Club-INTech/Balise-Ultrasons-TechTheTroll/README

Ceci est le dépôt de la balise de l'équipe TechTheTroll, conçue par Sylvain
