Club-INTech/Balise-Ultrasons-TechTheTroll/python/papier_presentation.tex

\documentclass[a4paper, 8pt]{article}

\usepackage{tikz}
\usepackage[T1]{fontenc}     
\usepackage[french]{babel}
\usepackage[utf8]{inputenc}   
\usepackage{amsmath}
\usepackage{amsmath}
\usepackage{enumitem}
\usepackage{hyperref}
\usepackage[]{algorithm2e}
\usepackage{geometry}
\geometry{hmargin=1cm,vmargin=1cm}

\title{Repérage grâce à un système de balise à ultrason et filtrage}
\author{Clément Besnier}
%\setlength{\textwidth}{500pt}
%\date{}
\begin{document}

\maketitle
\tableofcontents
\section{Introduction}

Chaque année a lieu la coupe de France de robotique. Durant cette compétition, deux robots évoluent sur une table de deux mètres sur trois en 90 secondes pour obtenir un maximum de points. La table étant partagée en même temps par deux robots, il est nécessaire d'éviter le robot adverse pour des raisons de sécurité et pour des raisons stratégiques. C'est la raison même d'un tel système de balisage.

\centerline{\input{schema_table.tex}}

\section{Système de balisage}

Le système de balisage est composé d'une partie émettrice et d'une partie réceptrice. La partie émettrice (PE) est placée sur le robot adverse et émet des ultrasons. La partie réceptrice (PR) est composée de trois balises qui se trouvent autour de la table (Voir figure 1). Les trois balises sont synchronisées entre elles mais ne le sont pas avec la partie émettrice. 

\section{Repérage}

PE émet à intervalle régulier un signal particulier. Soient $ t_{1}, t_{2}, t_{3}$  respectivement les dates de réception du même signal par PR. Comme PE et PR ne sont pas synchronisées il est impossible de calculer la durée entre l'émission du signal et sa réception et donc on ne peut pas trianguler le signal pour en retrouver l'origine. Cependant, on est certain des trois valeurs suivantes : 

\begin{equation}\label{1}
		\begin{split}
		& t_{1} - t_{2}\\
		& t_{1} - t_{3}\\
		& t_{2} - t_{3}
		\end{split}
\end{equation}

, ce qui est proportionnel à
\begin{equation}\label{2}
		\begin{split}
		& m_{1} = d((x,y),PR1)-d((x,y),PR2)\\
		& m_{2} = d((x,y),PR1)-d((x,y),PR3)\\
		& m_{3} = d((x,y),PR2)-d((x,y),PR3)
		\end{split}
\end{equation}

, il faut juste multiplier les différences de dates par la vitesse du son dans l'air dans des conditions normales. Les mesures $m_{1}, m_{2},  m_{3}$ permettent de retrouver (x,y) en résolvant le système. Vous pouvez trouver en annexe les équations (pas belles). Mais ce n'est pas comme ça qu'on va en réalité trouver ce qu'on veut.

\section{Modélisation et Simulation}

%Avant de pouvoir faire des mesures sur le robot, on simule les mesures en ajoutant un bruit gaussien aux $ m_{1}, m_{2},  m_{3}$.
Soit $X_t$, la position du robot à l'instant t.
\begin{equation}
	\begin{split}\label{3}
		X_t  &= \begin{pmatrix}
			x_t  \\
			y_t 
		\end{pmatrix}\\
	\end{split}
\end{equation}

Soit $Y_t$ la mesure prise à l'instant t.
\begin{equation} \label{4}
	\begin{split}
	Y_t &= \begin{pmatrix}
			m_1  \\
			m_2  \\
			m_3
		\end{pmatrix}\\
	\end{split}
\end{equation}

Soit H la fonction qui à une position (x, y) associe la différence de distance entre cette position etles balises suivant le schéma suivant : 
\begin{equation}
	\begin{split}\label{5}
		H(x, y)  &= 
		\begin{pmatrix}
				d((x,y),PR1) - d((x,y),PR2)\\
				d((x,y),PR1) - d((x,y),PR3)\\
				d((x,y),PR2) - d((x,y),PR3)
		\end{pmatrix}\\
	\end{split}
\end{equation}

On considère les $Y_t$ ainsi parce que c'est plus clair de raisonner avec des distances qu'avec des différences de temps. On notera les valeurs estimées avec un accent circonflexe sur la lettre, les valeurs simulées avec un tilde.
Soit E([$t_1$, $t_2$], PAS) une liste dont les éléments dont les multiples de $t_1$ compris entre $t_1$ et $t_2$. On considèrera dans la suite que l'unité de ses éléments est en seconde. 
[$t_1$, $t_2$] sera [0, 90] parce qu'un match dure 90 s. Le pas n'est pas encore décidé, cela dépendra des ressources disponibles du robot. On prendra pour l'exemple PAS = 0.025 s.

Pour le filtrage, on considérera ces équations avec Q, matrice de covariance de l'équation d'évolution et R, matrice de covariance de l'équation d'observation

L'équation d'observation est : 
\begin{equation}
	X_t = H(Y_t) + \mathcal{N}(0, R)
\end{equation}

L'équation d'évolution est : 
\begin{equation}
	X_{t+1} = G(X_{t}) + \mathcal{N}(0, Q)
\end{equation}

\begin{algorithm}[H]
		
		\Donnees{$C = [(x_t, y_t), t \in E([0, 90], 0.025)]$ le chemin, $\sigma^2$ la variance }
		\Res{$MB = [(m_1(t), m_2(t), m_3(t)]$}
		\ForAll{($x_t$, $y_t$) $\in$ C}
		{$m_1$, $m_2$, $m_3$ = h($x_t$, $y_t$) \\
		$\tilde{m_1}$, $\tilde{m_2}$, $\tilde{m_3}$ = {$m_1$} + $\mathcal{N}$(0, $\sigma^2$), {$m_2$} + $\mathcal{N}$(0, $\sigma^2$), {$m_3$} + $\mathcal{N}$(0, $\sigma^2$)\\
		Ajouter ($\tilde{m_1}$, $\tilde{m_2}$, $\tilde{m_3}$) à MB
		}
		
	\caption{Simulation du bruitage de mesures.}
	\end{algorithm}

\section{Filtrage}

On utilise ici un filtre de Kalman unscented.

%Algorithme de Kalman
%\begin{algorithm}[H]
%		
%		\KwData{$tag(w_{i}) = t_{i}$ et $tag(w_{i+1}) = t_{i+1} C(t_{i},t_{i+1}) = \{(w_i,w_{i+1})| T(w_i) = t_i~et~T(w_{i+1}) = t_{i+1} \}, w_{1:N}$}
%		\KwResult{$q_{i}(w_{i},w_{i+1}) i \in \{1 .. N-1\}$}
%		\eIf{$(w_{i},w_{i+1}) \in C(t_{i},t_{i+1}) $}{$q_{i}(w_{i},w_{i+1}) = p(t_{i},t_{i+1},w_{i},w_{i+1})$}{
%		\eIf{$w_{i} \in C(t_{i},t_{i+1})$ et $w_{i+1} \in C(t_{i},t_{i+1})$}{$q_{i}(w_{i},w_{i+1}) = p(t_{i},t_{i+1},w_{i}) * p(t_{i},t_{i+1},w_{i+1})$}{
%		\eIf{$w_{i} \in C(t_{i},t_{i+1})$}{$q_{i}(w_{i},w_{i+1}) = p(t_{i},t_{i+1},w_{i})$}{
%		\eIf{$w_{i+1} \in C(t_{i},t_{i+1})$}{$q_{i}(w_{i},w_{i+1}) = p(t_{i},t_{i+1},w_{i+1})$}{$q_{i}(w_{i},w_{i+1}) = p(t_{i},t_{i+1})$}}}}
%	\caption{Détermination de $q_i$ pour $i \in \{1..N-1\}$}
%	\end{algorithm}
%	

\begin{algorithm}[H]
\Donnees{d = 2 : dimension des mesures, $\alpha$ = 1, $\beta$ = 0, $\kappa$ = 2, $\mu_0$  : position initiale, $\Sigma_0$ matrice de covariance initiale, 

$\lambda$ = $\alpha^2*(d+\kappa)$ - d, $\gamma = d+\lambda$, 

Q : matrice de covariance de l'équation d'évolution, R : matrice de covariance de l'équation d'observation, 

H est décrite telle que dans la partie 4 et G est la fonction identité.

$w^{0}_m = \frac{\lambda}{d+\lambda}$, $w^{0}_c = w^{0}_m+(1-\alpha^2+\beta)$, $w^i_c = w^{i}_{m} = \frac{1}{2*(d+\lambda)}$}
%\KwResult{$q_{i}(w_{i},w_{i+1}) i \in \{1 .. N-1\}$}
\Repeter{plus aucune mesure}
{
	Partie prédiction :
	
	\Deb{$\sqrt{\Sigma}$ = decompositionDeCholesky($\gamma*\Sigma$);
		
	$\dot{\sigma}_{t-1}$ = [$\mu_{t-1}$; $\mu_{t-1} - \sqrt{\Sigma}_{:,i}~(i \in \{1, ..., d\}); \mu_{t-1} + \sqrt{\Sigma}_{:,i}~(i \in \{1,..., d\})$];
	
	\Pour{$i \in \{0,..., 2*d\}$}
	{
	$\bar{z}^{*~i}_t = G(\dot{\sigma}^{i}_{t-1})$;
	}
	$\bar{\mu}_{t} = \sum_{i = 0}^{2*d}w^i_m*\bar{z}^{*i}_t$;
	
	$\bar{\Sigma}_t = \sum_{i=0}^{2*d} w^i_c(\bar{z}^{*i}_t - \bar{\mu}_t)(\bar{z}^{*i}_t - \bar{\mu}_t)^{T} + Q_t$;}
	
	Partie mise-à-jour grâce à l'observation :
	
	\Deb{
	$\sqrt{\bar{\Sigma}}$ =decompositionDeCholesky($\gamma*\bar{\Sigma}$);
	
	$\bar{\dot{\sigma}}_{t}$ = [$\mu$; $\mu - \sqrt{\bar{\Sigma}_{:,i}}~(i \in \{1, ..., d\}); \mu + \sqrt{\bar{\Sigma}_{:,i}}~(i \in \{1,..., d\})$];
	
	\Pour{$i \in \{0,..., 2*d\}$}
	{
	$\bar{y}^{*~i}_t = H(\bar{\dot{\sigma}}^i_{t})$;
	}
	
	$\hat{y}^{*i}_t = \sum_{i = 0}^{2*d} w^{i}_{m}*\bar{y}^{*i}_{t}$;
	
	$S_t = \sum_{i=0}^{2*d} w_{c}^{i}(\bar{y}^{*i}_t - \hat{y}^{*i}_t)*(\bar{y}^{*i}_t - \hat{y}^{*i}_t)^{T} + R_t$;}
	
	Partie estimation de l'état actuel :
	
	\Deb{
	$\bar{\Sigma}^{z,y}_t = \sum_{i=0}^{2*d} w^{i}_{c} (\bar{z}^{*i}_t - \bar{\mu}_t)*(\bar{y}^{*i}_t - \hat{y}^{*i}_t)^{T}$;
	
	$K_t = \bar{\Sigma}^{z,y}_t*S_t^{-1}$;
	
	$\mu_t = \bar{\mu}+K_t*(y_t - \hat{y}_{t}) $;
	
	$\Sigma_t = \bar{\Sigma} - K_t*S_t*K^T_t$;
		
	}
		
}
		
	\caption{Algorithme de Kalman Unscented}
	\end{algorithm}

\section{De la mesure venant des balises à la mesure qui rejoint le modèle}

Sylvain donne les mesures et obtient trois valeurs pour une salve de mesures qu'on va appeler $t_1, t_2, t_3$. J'ai vu que nous avions tous les 3 un positionnement des balises différent. J'ai donc fait des échanges comme il convient.
Position (-1500, 0). Sylvain : 1. Clément : 1. Ivan : 2.
Position (-1500, 2000). Sylvain : 2. Clément : 3. Ivan : 3.
Position (1500, 1000). Sylvain : 3. Clément : 2. Ivan : 1.
Donc il faut faire les échanges de valeurs en conséquence. Les valeurs sont en microsecondes donc il faut les convertir en secondes en divisant par $10^6$. Il faut convertir ce temps en distance (qui pour l'instant ne veut rien dire) en multipliant par la vitesse du son en millimètre par seconde. On obient alors des distances que l'on appelle $d_1, d_2, d_3$. Il suffit de faire les différences de distance comme il suit : $m_1 = d_1 - d_2, m_2 = d_1 - d_3, m_3 = d_2 - d_3$.

Pour résumer, Ivan, tu dois faire : $m_1 = (t_3 - t_1)*v_s/10^6, m_2 = (t_3 - t_2)*v_s/10^6, m_3 = (t_1 - t_2)*v_s/10^6$.

Pour résumer, et moi je dois faire : $m_1 = (t_1 - t_3)*v_s/10^6, m_2 = (t_1 - t_2)*v_s/10^6, m_3 = (t_3 - t_2)*v_s/10^6$.

\section{Annece I : Notations}
Soit M une matrice de taille (m, n). On note $M_{:,i}$ le vecteur colonne correspondant à la colonne i ($i \in \{1,...,n\}$) de M.

\section{Annexe II : mesure vers état}

Les trois équations du système représentent trois équations d'hyperbole. (x,y) se retrouvent à l'intersection de trois branches d'hyperbole. Cependant,la formule donnée à Mathematica (CHANGER LA FORMULATION) donne, pour chaque couple possible d'équation, deux solutions. Au total il y a 6 solutions.

\begin{itemize}[label=$\bullet$]
		
\item équation 1 1 2
{\tiny
\begin{equation} \label{3}
	\begin{split}
	a & = \sqrt{-(-10+{{m}_{1}}^{2})*{({m}_{1}+{m}_{2})}^{2}*(-10+{{m}_{2}}^{2})*(-4+{{m}_{1}}^{2}-2*{{m}_{1}}^{2}+{{m}_{2}}^{2})}\\
	x & = \frac{-(-12+6*{{m}_{1}}^{2}-12*{m}_{1}*{m}_{2}+3*{{m}_{1}}^{3}*{m}_{2}+6*{{m}_{2}}^{2}-6*{{m}_{1}}^{2}*{{m}_{2}}^{2}+3*{m}_{1}*{{m}_{2}}^{3}+a)}{4*(-18+5*{{m}_{1}}^{2}-8*{m}_{1}*{m}_{2}+5*{{m}_{2}}^{2})} \\
	Q & = 4*({m}_{1}+{m}_{2})*(-18+5*{{m}_{1}}^{2}-8*{m}_{1}*{m}_{2}+5*{{m}_{2}}^{2})\\
	y & =  \frac{-1}{Q*(72*{m}_{1}-28*{{m}_{1}}^{3}+72*{m}_{2}+4*{{m}_{1}}^{2}*{m}_{2}+{{m}_{1}}^{4}*{m}_{2}+20*{m}_{1}*{{m}_{2}}^{2}+{{m}_{1}}^{3}*{{m}_{2}}^{2}-12*{{m}_{2}}^{3}-{{m}_{1}}^{2}*{{m}_{2}}^{3}-{m}_{1}*{{m}_{2}}^{4}-3*{m}_{1}*a+3*{m}_{2}*a)} 
	\end{split}
	\end{equation}
}
\item équation 2 1 2
{\tiny
   \begin{equation} \label{4}
   	\begin{split}
    a & = \sqrt{-(-10+{{m}_{1}}^{2})*{({m}_{1}+{m}_{2})}^{2}*(-10+{{m}_{2}}^{2})*(-4+{{m}_{1}}^{2}-2*{m}_{1}*{m}_{2}+{{m}_{2}}^{2})}\\
   	x & = \frac{-(-12+6*{{m}_{1}}^{2}-12*{m}_{1}*{m}_{2}+3*{{m}_{1}}^{3}*{m}_{2}+6*{{m}_{2}}^{2}-6*{{m}_{1}}^{2}*{{m}_{2}}^{2}+3*{m}_{1}*{{m}_{2}}^{3}-a)}{4*(-18+5*{{m}_{1}}^{2}-8*{m}_{1}*{m}_{2}+5*{{m}_{2}}^{2})} \\
   	Q & = 4*({m}_{1}+{m}_{2})*(-18+5* {{m}_{1}}^{2}-8*{m}_{1}*{m}_{2}+5*{{m}_{2}}^{2})\\
   	 y &  = \frac{-1}{Q*(72*{m}_{1}-28*{{m}_{1}}^{3}+72*{m}_{2}+4*{{m}_{1}}^{2}*{m}_{2}+{{m}_{1}}^{4}*{m}_{2}+20*{m}_{1}*{{m}_{2}}^{2}+{{m}_{1}}^{3}*{{m}_{2}}^{2}-12*{{m}_{2}}^{3}-{{m}_{1}}^{2}* {{m}_{2}}^{3}-{m}_{1}*{{m}_{2}}^{4}+3*{m}_{1}*a-3*{m}_{2}*a)} 
   	\end{split}
   	\end{equation}
}
\item équation 1 2 3
{\tiny
 \begin{equation} \label{5}
   	\begin{split}
   a & = \sqrt{-(-10+{{m}_{2}}^{2})*{(-2*{m}_{2}+{m}_{3})}^{2}*(-4+{{m}_{3}}^{2})*(-10+{{m}_{2}}^{2}-2*{m}_{2}*{m}_{3}+{{m}_{3}}^{2})}\\
   x  & =  \frac{-(-12+6*{{m}_{3}}^{2}+3*{{m}_{2}}^{2}*{{m}_{3}}^{2}-3*{m}_{2}*{{m}_{3}}^{3}-a)}{4*(-18+2*{{m}_{2}}^{2}-2*{m}_{2}*{m}_{3}+5*{{m}_{3}}^{2})} \\
   	 y &  = \frac{-144*{m}_{2}+16*{{m}_{2}}^{3}+72*{m}_{3}-56*{{m}_{2}}^{2}*{m}_{3}+4*{{m}_{2}}^{4}*{m}_{3}+80*{m}_{2}*{{m}_{3}}^{2}-8*{{m}_{2}}^{3}*{{m}_{3}}^{2}-28*{{m}_{3}}^{3}+5*{{m}_{2}}^{2}*{{m}_{3}}^{3}-{m}_{2}*{{m}_{3}}^{4}+3*{m}_{3}*a}{4*(2*{m}_{2}-{m}_{3})*(-18+2*{{m}_{2}}^{2}-2*{m}_{2}*{m}_{3}+5*{{m}_{3}}^{2})}
   	\end{split}
 \end{equation}
}
\item équation 2 2 3
{\tiny
\begin{equation} \label{6}
   	\begin{split}
   [a & = \sqrt-(-10+{{m}_{2}}^{2})*{(-2*{m}_{2}+{m}_{3})}^{2}*(-4+{{m}_{3}}^{2})*(-10+{{m}_{2}}^{2}-2*{m}_{2}*{m}_{3}+{{m}_{3}}^{2})\\
  x & = \frac{-(-12+6*{{m}_{3}}^{2}+3*{{m}_{2}}^{2}*{{m}_{3}}^{2}-3*{m}_{2}*{{m}_{3}}^{3}+a)}{4*(-18+2*{{m}_{2}}^{2} -2*{m}_{2}*{m}_{3}+5*{{m}_{3}}^{2})} \\
   	 y & = \frac{-144*{m}_{2}+16*{{m}_{2}}^{3}+72*{m}_{3}-56*{{m}_{2}}^{2}*{m}_{3}+4*{{m}_{2}}^{4}*{m}_{3}+80*{m}_{2}*{{m}_{3}}^{2}-8*{{m}_{2}}^{3}*{{m}_{3}}^{2}-28*{{m}_{3}}^{3}+5*{{m}_{2}}^{2}*{{m}_{3}}^{3}-{m}_{2}*{{m}_{3}}^{4}-3*{m}_{3}*a}{4*(2*{m}_{2}-{m}_{3})*(-18+2*{{m}_{2}}^{2}-2*{m}_{2}*{m}_{3}+5*{{m}_{3}}^{2})}
   	\end{split}
\end{equation}
}

\item équation 1 3 1
{\tiny
\begin{equation} \label{7}
   	\begin{split}
  a & = \sqrt{(-(-10+{{m}_{1}}^{2})*{(2*{m}_{1}+{m}_{3})}^{2}*(-4+{{m}_{3}}^{2})*(-10+{{m}_{1}}^{2}+2*{m}_{1}*{m}_{3}+{{m}_{3}}^{2}))}\\
  x & = \frac{-(-12+6*{{m}_{3}}^{2}+3*{{m}_{1}}^{2}*{{m}_{3}}^{2}+3*{m}_{1}*{{m}_{3}}^{3}+a)}{4*(-18+2* {{m}_{1}}^{2}+2*{m}_{1}*{m}_{3}+5*{{m}_{3}}^{2})} \\
   	 y & = \frac{-144*{m}_{1}+16*{{m}_{1}}^{3}-72*{m}_{3}-8*{{m}_{1}}^{2}*{m}_{3}+4*{{m}_{1}}^{4}*{m}_{3}+16*{m}_{1}*{{m}_{3}}^{2}+8*{{m}_{1}}^{3}*{{m}_{3}}^{2}+12*{{m}_{3}}^{3}+5*{{m}_{1}}^{2}*{{m}_{3}}^{3}+{m}_{1}*{{m}_{3}}^{4}-3*{m}_{3}*a}{4*(2*{m}_{1}+{m}_{3})*(-18+2*{{m}_{1}}^{2}+2*{m}_{1}*{m}_{3}+5*{{m}_{3}}^{2})}
   	\end{split}
\end{equation}
}
\item équation 2 3 1
{\tiny
\begin{equation} \label{8}
   	\begin{split}
	  a & = \sqrt{-(-10+{{m}_{1}}^{2})*{(2*{m}_{1}+{m}_{3})}^{2}*(-4+{{m}_{3}}^{2})*(-10+{{m}_{1}}^{2}+2*{m}_{1}*{m}_{3}+{{m}_{3}}^{2})}\\
	  x & = \frac{-(-12+6*{{m}_{3}}^{2}+3*{{m}_{1}}^{2}*{{m}_{3}}^{2}+3*{m}_{1}*{{m}_{3}}^{3}-a)}{4*(-18+2*{{m}_{1}}^{2}+2*{m}_{1}*{m}_{3}+5*{{m}_{3}}^{2})} \\
   		 y & = \frac{-144*{m}_{1}+16*{{m}_{1}}^{3}-72*{m}_{3}-8*{{m}_{1}}^{2}*{m}_{3}+4*{{m}_{1}}^{4}*{m}_{3}+16*{m}_{1}*{{m}_{3}}^{2}+8*{{m}_{1}}^{3}*{{m}_{3}}^{2}+12*{{m}_{3}}^{3}+5*{{m}_{1}}^{2}*{{m}_{3}}^{3}+{m}_{1}*{{m}_{3}}^{4}+3*{m}_{3}*a}{4*(2*{m}_{1}+{m}_{3})*(-18+2*{{m}_{1}}^{2}+2*{m}_{1}*{m}_{3}+5*{{m}_{3}}^{2})}
   	\end{split}
\end{equation}
}
\end{itemize}

\bibliographystyle{plain}
\bibliography{biblio}
\nocite{DBLP:conf/icassp/MerweW01}
\nocite{DBLP:journals/ipl/BoroujerdiU98}
\end{document}
