Club-INTech/Balise-Ultrasons-TechTheTroll/python/papier_presentation.pdf

## Repérage grâce à un système de balise à ultrason et filtrage

Clément Besnier

22 mai 2016

## Table des matières

1 Introduction | 1
2 Système de balisage | 1
3 Repérage | 1
4 Modélisation et Simulation | 2
5 Filtrage | 3
6 De la mesure venant des balises à la mesure qui rejoint le modèle | 3
7 Annece I : Notations | 3
8 Annexe II : mesure vers état | 3

## 1 Introduction

Chaque année a lieu la coupe de France de robotique. Durant cette compétition, deux robots évoluent sur une table de deux mètres sur trois en 90 secondes pour obtenir un maximum de points. La table étant partagée en même temps par deux robots, il est nécessaire d’éviter le robot adverse pour des raisons de sécurité et pour des raisons stratégiques. C’est la raison même d’un tel système de balisage.

## 2 Système de balisage

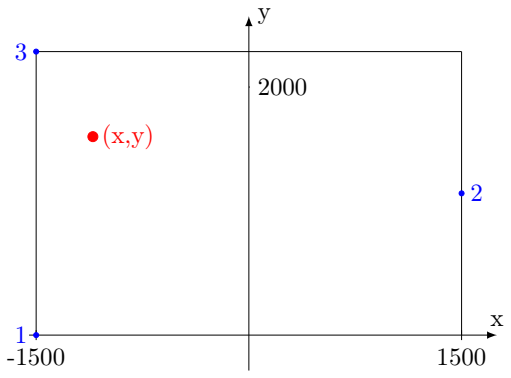
[picture p4: figure]

Le système de balisage est composé d’une partie émettrice et d’une partie réceptrice. La partie émettrice (PE) est placée sur le robot adverse et émet des ultrasons. La partie réceptrice (PR) est composée de trois balises qui se trouvent autour de la table (Voir figure 1). Les trois balises sont synchronisées entre elles mais ne le sont pas avec la partie émettrice.

## 3 Repérage

PE émet à intervalle régulier un signal particulier. Soient t1, t2, t3 respectivement les dates de réception du même signal par PR. Comme PE et PR ne sont pas synchronisées il est impossible de calculer la durée entre l’émission du signal et sa réception et donc on ne peut pas trianguler le signal pour en retrouver l’origine. Cependant, on est certain des trois valeurs suivantes :

t1 − t2
t1 − t3
t2 − t3

(1)

, ce qui est proportionnel à

m1 = d((x, y), P R1) − d((x, y), P R2) m2 = d((x, y), P R1) − d((x, y), P R3) m3 = d((x, y), P R2) − d((x, y), P R3)

(2)

, il faut juste multiplier les différences de dates par la vitesse du son dans l’air dans des conditions normales. Les mesures m1, m2, m3 permettent de retrouver (x,y) en résolvant le système. Vous pouvez trouver en annexe les équations (pas belles). Mais ce n’est pas comme ça qu’on va en réalité trouver ce qu’on veut.

## 4 Modélisation et Simulation

Soit Xt, la position du robot à l’instant t.

Xt =

xt
yt
(3)

Soit Yt la mesure prise à l’instant t.

Yt =

m1
m2
m3
- (4)

Soit H la fonction qui à une position (x, y) associe la différence de distance entre cette position etles balises suivant le schéma suivant :

H(x, y) =

d((x, y), P R1) − d((x, y), P R2) d((x, y), P R1) − d((x, y), P R3) d((x, y), P R2) − d((x, y), P R3)

- (5)

On considère les Yt ainsi parce que c’est plus clair de raisonner avec des distances qu’avec des différences de temps. On notera les valeurs estimées avec un accent circonflexe sur la lettre, les valeurs simulées avec un tilde. Soit E([t1, t2], PAS) une liste dont les éléments dont les multiples de t1 compris entre t1 et t2. On considèrera dans la suite que l’unité de ses éléments est en seconde. [t1, t2] sera [0, 90] parce qu’un match dure 90 s. Le pas n’est pas encore décidé, cela dépendra des ressources disponibles du robot. On prendra pour l’exemple PAS = 0.025 s.
Pour le filtrage, on considérera ces équations avec Q, matrice de covariance de l’équation d’évolution et R, matrice de covariance de l’équation d’observation
L’équation d’observation est :
Xt = H(Yt) + N (0, R) | (6)

L’équation d’évolution est :
Xt+1 = G(Xt) + N (0, Q) | (7)

Données: C = [(xt, yt), t ∈ E([0, 90], 0.025)] le chemin, σ

2
la variance
Résultat: MB = [(m1(t), m2(t), m3(t)]
forall the (xt, yt) ∈ C do
m1, m2, m3 = h(xt, yt)
m˜1, m˜2, m˜3 = m1 + N (0, σ

2
), m2 + N (0, σ

2
), m3 + N (0, σ

2
)
Ajouter (m˜1, m˜2, m˜3) à MB end
Algorithm 1: Simulation du bruitage de mesures.

## 5 Filtrage

On utilise ici un filtre de Kalman unscented.
Données: d = 2 : dimension des mesures, α = 1, β = 0, κ = 2, µ0 : position initiale, Σ0 matrice de covariance initiale, λ = α

2 ∗ (d + κ) - d, γ = d + λ,
Q : matrice de covariance de l’équation d’évolution, R : matrice de covariance de l’équation d’observation,
H est décrite telle que dans la partie 4 et G est la fonction identité.
w

0
m =

λ
d+λ

, w

0
c = w

0
m + (1 − α

2 + β), w

i
c = w

i
m =

1
2∗(d+λ)
répéter
Partie prédiction :
début
√
Σ = decompositionDeCholesky(γ ∗ Σ) ; σ˙ t−1 = [µt−1 ; µt−1 −

√
Σ:,i (i ∈ {1, ..., d}); µt−1 +

√
Σ:,i (i ∈ {1, ..., d})] ;
pour i ∈ {0, ..., 2 ∗ d} faire z¯

∗ i
t = G( ˙σ

i
t−1

);
fin
µ¯t =

P2∗d
| i=0 w i m ∗ z¯

∗i
t

;
Σ¯
t = | P2∗d
| i=0 w i
| c (¯z

∗i
t − µ¯t)(¯z

∗i
t − µ¯t)

T + Qt ;
fin
Partie mise-à-jour grâce à l’observation : début
√
Σ¯ =decompositionDeCholesky(γ ∗ Σ¯) ; σ¯˙ t = [µ ; µ −
p

Σ¯
:,i (i ∈ {1, ..., d}); µ +

p

Σ¯
:,i (i ∈ {1, ..., d})] ;
pour i ∈ {0, ..., 2 ∗ d} faire y¯

∗ i

t = H(σ¯˙
i
t

);
fin
yˆ

∗i
t =

P2∗d
i=0 w

i
m ∗ y¯

∗i
t

;
St =

P2∗d
i=0 w

i
c

(¯y

∗i
t − yˆ

∗i
t

) ∗ (¯y

∗i
t − yˆ

∗i
t

)

T + Rt ;
fin
Partie estimation de l’état actuel : début
Σ¯ z,y
t =

P2∗d
i=0 w

i
c

(¯z

∗i
t − µ¯t) ∗ (¯y

∗i
t − yˆ

∗i
t

)

T
;
Kt = Σ¯ z,y
t ∗ S

−1
t

;
µt = ¯µ + Kt ∗ (yt − yˆt); Σt = Σ¯ − Kt ∗ St ∗ KT
t

;
fin
jusqu’à plus aucune mesure;
Algorithm 2: Algorithme de Kalman Unscented

## 6 De la mesure venant des balises à la mesure qui rejoint le modèle

Sylvain donne les mesures et obtient trois valeurs pour une salve de mesures qu’on va appeler t1, t2, t3. J’ai vu que nous avions tous les 3 un positionnement des balises différent. J’ai donc fait des échanges comme il convient. Position (-1500, 0). Sylvain : 1. Clément : 1. Ivan : 2. Position (-1500, 2000). Sylvain : 2. Clément : 3. Ivan : 3. Position (1500, 1000). Sylvain :
3. Clément : 2. Ivan : 1. Donc il faut faire les échanges de valeurs en conséquence. Les valeurs sont en microsecondes donc il faut les convertir en secondes en divisant par 10⁶
. Il faut convertir ce temps en distance (qui pour l’instant ne veut rien dire) en multipliant par la vitesse du son en millimètre par seconde. On obient alors des distances que l’on appelle d1, d2, d3. Il suffit de faire les différences de distance comme il suit : m1 = d1 − d2, m2 = d1 − d3, m3 = d2 − d3.
Pour résumer, Ivan, tu dois faire : m1 = (t3 − t1) ∗ vs/10⁶

, m2 = (t3 − t2) ∗ vs/10⁶

, m3 = (t1 − t2) ∗ vs/10⁶
Pour résumer, et moi je dois faire : m1 = (t1 − t3) ∗ vs/10⁶

, m2 = (t1 − t2) ∗ vs/10⁶

, m3 = (t3 − t2) ∗ vs/10⁶

## 7 Annece I : Notations

Soit M une matrice de taille (m, n). On note M:,i le vecteur colonne correspondant à la colonne i (i ∈ {1, ..., n}) de M.

## 8 Annexe II : mesure vers état

Les trois équations du système représentent trois équations d’hyperbole. (x,y) se retrouvent à l’intersection de trois branches d’hyperbole. Cependant,la formule donnée à Mathematica (CHANGER LA FORMULATION) donne, pour chaque couple possible d’équation, deux solutions. Au total il y a 6 solutions.

- équation 1 1 2

a =

q
−(−10 + m1
2) ∗ (m1 + m2)² ∗ (−10 + m2
2) ∗ (−4 + m1

2 − 2 ∗ m1

2 + m2

2)

x =

−(−12 + 6 ∗ m1

2 − 12 ∗ m1 ∗ m2 + 3 ∗ m1

3 ∗ m2 + 6 ∗ m2

2 − 6 ∗ m1

2 ∗ m2

2 + 3 ∗ m1 ∗ m2

3 + a)

4 ∗ (−18 + 5 ∗ m1

2 − 8 ∗ m1 ∗ m2 + 5 ∗ m2

2)

Q = 4 ∗ (m1 + m2) ∗ (−18 + 5 ∗ m1

2 − 8 ∗ m1 ∗ m2 + 5 ∗ m2

2)

y =

−1

Q ∗ (72 ∗ m1 − 28 ∗ m1

3 + 72 ∗ m2 + 4 ∗ m1

2 ∗ m2 + m1

4 ∗ m2 + 20 ∗ m1 ∗ m2

2 + m1

3 ∗ m2

2 − 12 ∗ m2

3 − m1

2 ∗ m2

3 − m1 ∗ m2

4 − 3 ∗ m1 ∗ a + 3 ∗ m2 ∗ a) (8)

- équation 2 1 2

a =

q
−(−10 + m1
2) ∗ (m1 + m2)² ∗ (−10 + m2
2) ∗ (−4 + m1

2 − 2 ∗ m1 ∗ m2 + m2

2)

x =

−(−12 + 6 ∗ m1

2 − 12 ∗ m1 ∗ m2 + 3 ∗ m1

3 ∗ m2 + 6 ∗ m2

2 − 6 ∗ m1

2 ∗ m2

2 + 3 ∗ m1 ∗ m2

3 − a)

4 ∗ (−18 + 5 ∗ m1

2 − 8 ∗ m1 ∗ m2 + 5 ∗ m2

2)

Q = 4 ∗ (m1 + m2) ∗ (−18 + 5 ∗ m1

2 − 8 ∗ m1 ∗ m2 + 5 ∗ m2

2)

y =

−1

Q ∗ (72 ∗ m1 − 28 ∗ m1

3 + 72 ∗ m2 + 4 ∗ m1

2 ∗ m2 + m1

4 ∗ m2 + 20 ∗ m1 ∗ m2

2 + m1

3 ∗ m2

2 − 12 ∗ m2

3 − m1

2 ∗ m2

3 − m1 ∗ m2

4 + 3 ∗ m1 ∗ a − 3 ∗ m2 ∗ a) (9)

- équation 1 2 3

a =

q
−(−10 + m2
2) ∗ (−2 ∗ m2 + m3)² ∗ (−4 + m3
2) ∗ (−10 + m2

2 − 2 ∗ m2 ∗ m3 + m3

2)

x =

−(−12 + 6 ∗ m3

2 + 3 ∗ m2

2 ∗ m3

2 − 3 ∗ m2 ∗ m3

3 − a)

4 ∗ (−18 + 2 ∗ m2

2 − 2 ∗ m2 ∗ m3 + 5 ∗ m3

2)

y =

−144 ∗ m2 + 16 ∗ m2

3 + 72 ∗ m3 − 56 ∗ m2

2 ∗ m3 + 4 ∗ m2

4 ∗ m3 + 80 ∗ m2 ∗ m3

2 − 8 ∗ m2

3 ∗ m3

2 − 28 ∗ m3

3 + 5 ∗ m2

2 ∗ m3

3 − m2 ∗ m3

4 + 3 ∗ m3 ∗ a

4 ∗ (2 ∗ m2 − m3) ∗ (−18 + 2 ∗ m2

2 − 2 ∗ m2 ∗ m3 + 5 ∗ m3

2)

(10)

- équation 2 2 3

[a =

p
−(−10 + m2
2) ∗ (−2 ∗ m2 + m3)

2 ∗ (−4 + m3

2) ∗ (−10 + m2

2 − 2 ∗ m2 ∗ m3 + m3

2)

x =

−(−12 + 6 ∗ m3

2 + 3 ∗ m2

2 ∗ m3

2 − 3 ∗ m2 ∗ m3

3 + a)

4 ∗ (−18 + 2 ∗ m2

2 − 2 ∗ m2 ∗ m3 + 5 ∗ m3

2)

y =

−144 ∗ m2 + 16 ∗ m2

3 + 72 ∗ m3 − 56 ∗ m2

2 ∗ m3 + 4 ∗ m2

4 ∗ m3 + 80 ∗ m2 ∗ m3

2 − 8 ∗ m2

3 ∗ m3

2 − 28 ∗ m3

3 + 5 ∗ m2

2 ∗ m3

3 − m2 ∗ m3

4 − 3 ∗ m3 ∗ a

4 ∗ (2 ∗ m2 − m3) ∗ (−18 + 2 ∗ m2

2 − 2 ∗ m2 ∗ m3 + 5 ∗ m3

2)
(11)
- équation 1 3 1

a =

q
(−(−10 + m1
2) ∗ (2 ∗ m1 + m3)² ∗ (−4 + m3
2) ∗ (−10 + m1

2 + 2 ∗ m1 ∗ m3 + m3

2))

x =

−(−12 + 6 ∗ m3

2 + 3 ∗ m1

2 ∗ m3

2 + 3 ∗ m1 ∗ m3

3 + a)

4 ∗ (−18 + 2 ∗ m1

2 + 2 ∗ m1 ∗ m3 + 5 ∗ m3

2)

y =

−144 ∗ m1 + 16 ∗ m1

3 − 72 ∗ m3 − 8 ∗ m1

2 ∗ m3 + 4 ∗ m1

4 ∗ m3 + 16 ∗ m1 ∗ m3

2 + 8 ∗ m1

3 ∗ m3

2 + 12 ∗ m3

3 + 5 ∗ m1

2 ∗ m3

3 + m1 ∗ m3

4 − 3 ∗ m3 ∗ a

4 ∗ (2 ∗ m1 + m3) ∗ (−18 + 2 ∗ m1

2 + 2 ∗ m1 ∗ m3 + 5 ∗ m3

2)

(12)

- équation 2 3 1

a =

q
−(−10 + m1
2) ∗ (2 ∗ m1 + m3)² ∗ (−4 + m3
2) ∗ (−10 + m1

2 + 2 ∗ m1 ∗ m3 + m3

2)

x =

−(−12 + 6 ∗ m3

2 + 3 ∗ m1

2 ∗ m3

2 + 3 ∗ m1 ∗ m3

3 − a)

4 ∗ (−18 + 2 ∗ m1

2 + 2 ∗ m1 ∗ m3 + 5 ∗ m3

2)

y =

−144 ∗ m1 + 16 ∗ m1

3 − 72 ∗ m3 − 8 ∗ m1

2 ∗ m3 + 4 ∗ m1

4 ∗ m3 + 16 ∗ m1 ∗ m3

2 + 8 ∗ m1

3 ∗ m3

2 + 12 ∗ m3

3 + 5 ∗ m1

2 ∗ m3

3 + m1 ∗ m3

4 + 3 ∗ m3 ∗ a

4 ∗ (2 ∗ m1 + m3) ∗ (−18 + 2 ∗ m1

2 + 2 ∗ m1 ∗ m3 + 5 ∗ m3

2)

(13)

## Références

[1] Ali Boroujerdi and Jeffrey K. Uhlmann. An efficient algorithm for computing least cost paths with turn constraints. Inf. Process. Lett., 67(6) :317–321, 1998.
[2] Rudolph van der Merwe and Eric A. Wan. The square-root unscented kalman filter for state and parameter-estimation. In IEEE International Conference on Acoustics, Speech, and Signal Processing, ICASSP 2001, 7-11 May, 2001, Salt Palace Convention Center, Salt Lake City, Utah, USA, Proceedings, pages 3461–3464, 2001.
