Club-INTech/Balise-Ultrasons-TechTheTroll/python/schema_table.pdf

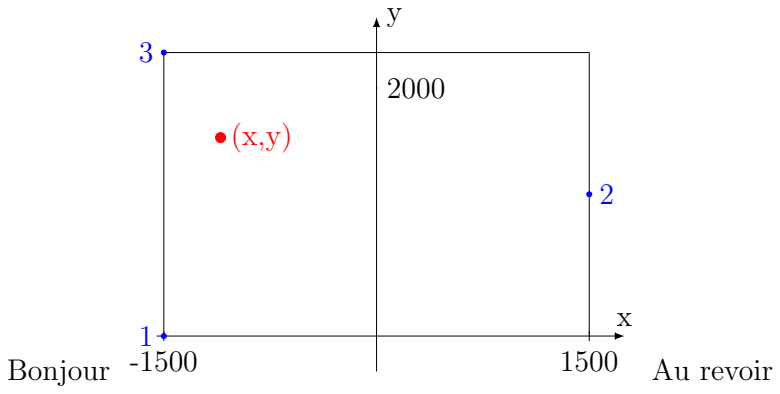
[picture p5: figure]
Bonjour; Au revoir

1
