Club-INTech/Balise-Ultrasons-TechTheTroll/filtrage/Sallen-Key_Highpass.png

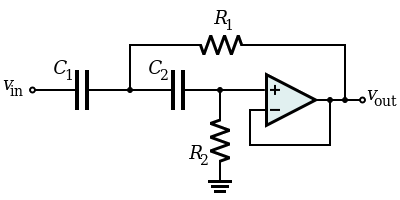
filtrage/Sallen-Key_Highpass.png
