Club-INTech/Balise-Ultrasons-TechTheTroll/electronique/liste des courses.xlsx

 |  |  |  |  |  |  |  | nbEmetteurs | nbRecepteurs | nbAlim
 |  |  |  |  |  |  |  | 1 | 3 | 1
 |  |  |  |  | qté dans chaque circuit :
 |  | ref RS | nom | prix HT | émetteur | récepteur | alim | Total | déjà acheté | à acheter | Prix
Circuits intégrés |  | 759-0888 | Multiplieur AD633JN | 8.29 | 1 | 1 | 0 | 4 | 4 | 0 | 0
 |  | 304-201 | 4*AOP TL084IP | 0.52 | 2 | 3 | 0 | 11 | 10 | 1 | 0.52
 |  | ? | Regulateur 3V3 | 0 | 0 | 0 | 1 | 1 | 0 | 1 | 0
 | * | 666-4379 | Regulateur 5V | 4.49 | 1 | 0 | 1 | 2 | 0 | 2 | 8.98
 |  | 311-4764 | DC-DC Converter 2W | 6.94 | 1 | 0 | 0 | 1 | 1 | 0 | 0
 |  | 755-3532 | DC-DC Converter 6W | 21.01 | 0 | 0 | 1 | 1 | 0 | 1 | 21.01
Connectique et interrupteurs |  | 257-8779 | RJ45 femelle | 0.44 | 0 | 2 | 0 | 6 | 0 | 6 | 2.64
 |  | INTech | Interrupteur 3pos | 0 | 0 | 1 | 0 | 3 | 0 | 3 | 0
 | * | 787-4855 | Interrupteur 2pos ON-ON | 0.57 | 1 | 0 | 1 | 2 | 0 | 2 | 1.14
 |  | INTech | Support CI 7*2 | 0 | 2 | 3 | 0 | 11 | 0 | 11 | 0
 |  | INTech | Support CI 4*2 | 0 | 1 | 1 | 0 | 4 | 0 | 4 | 0
 |  | 687-8008 | Connecteur 7*1 femelle | 0.352 | 1 | 0 | 0 | 1 | 0 | 1 | 0.352
 |  | 687-7152 | Contacts pour connecteur femelle | 0.027 | 7 | 0 | 0 | 7 | 0 | 7 | 0.189
 |  | 687-8058 | Connecteur 7*1 mâle | 0.089 | 1 | 0 | 0 | 1 | 0 | 1 | 0.089
Diodes |  | 628-9029 | Diode 1N4004 1A | 0.174 | 1 | 1 | 0 | 4 | 0 | 4 | 0.696
 |  | INTech | Diode miniature | 0 | 0 | 0 | 6 | 6 | 0 | 6 | 0
Résistances |  | 625-1513 | Potentiomètre 100K | 0.9 | 0 | 3 | 0 | 9 | 0 | 9 | 8.1
 |  | 850-9625 | Potentiomètre 10K | 0.37 | 8 | 0 | 0 | 8 | 0 | 8 | 2.96
 |  | 796-4803 | Potentiomètre 2K | 0.89 | 1 | 2 | 0 | 7 | 0 | 7 | 6.23
 |  | 769-2136 | Potentiomètre 500 | 0.95 | 0 | 2 | 0 | 6 | 0 | 6 | 5.7
Condensateur |  | 721-5240 | 100nF |  | n
 |  | 335-000 | 1,5µF |  | 1 |  |  |  |  | Prix HT : | 58.606
 |  | 877-3444 | 2,2nF |  | 3 |  |  |  |  | Prix total : | 70.3272
Résistances |  | 148-528 | 1K2 |  | 3 |  |  |  |  | Total des factures précédentes : |  | 76.52
 |  | 133-217 | 1M |  | 2 |  |  |  |  | Facture dipole electronique : |  | 174
 |  |  |  |  |  |  |  |  |  | Dont commande ampli audio : |  | 50
 |  |  |  |  |  |  |  |  |  | Facture circuits électroniques : |  | 124
 |  |  |  |  |  |  |  |  |  | Total des dépenses : |  | 270.8472
