Club-INTech/Balise-Ultrasons-TechTheTroll/Benchmark/Data4.xlsx

B0 | B1 | B2 | d1=B0-B1 | d2=B0-B2
721607318 |  | 721609105 | 721607318 | -1787
721619322 | 721615449 | 721621266 | 3873 | -1944
721631339 | 721627448 | 721633400 | 3891 | -2061
721643364 | 721639462 | 721645503 | 3902 | -2139
721655389 | 721651480 | 721657579 | 3909 | -2190
721667412 | 721663484 | 721669630 | 3928 | -2218
721679435 | 721675477 | 721681670 | 3958 | -2235
721691454 | 721687468 | 721693700 | 3986 | -2246
721703467 | 721699470 | 721705722 | 3997 | -2255
721715474 | 721711487 | 721717738 | 3987 | -2264
721727477 | 721723507 | 721729751 | 3970 | -2274
721739476 | 721735520 | 721741766 | 3956 | -2290
721751474 | 721747525 | 721753781 | 3949 | -2307
721763467 | 721759525 | 721765797 | 3942 | -2330
721775456 | 721771524 | 721777812 | 3932 | -2356
721787440 | 721783524 | 721789827 | 3916 | -2387
721799423 | 721795523 | 721801839 | 3900 | -2416
721811412 | 721807518 | 721813842 | 3894 | -2430
721823405 | 721819512 | 721825834 | 3893 | -2429
721835393 | 721831506 | 721837820 | 3887 | -2427
721847373 | 721843506 | 721849804 | 3867 | -2431
721859351 | 721855507 | 721861787 | 3844 | -2436
721871324 | 721867499 | 721873773 | 3825 | -2449
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
