Club-INTech/Balise-Ultrasons-TechTheTroll/electronique/balise réceptrice/balise réceptrice - puissance et communication.brd

## EAGLE design electronique/balise réceptrice/balise réceptrice - puissance et communication.brd (2016-03-05)

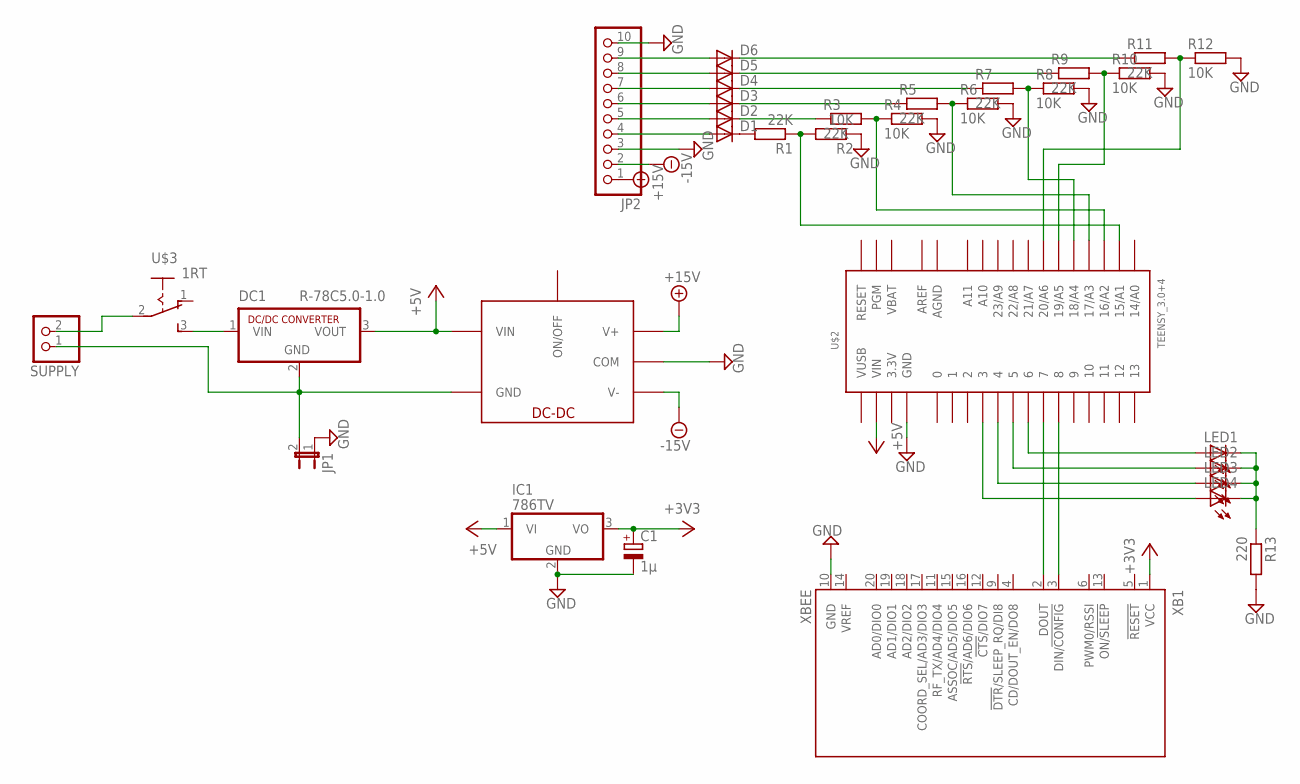
[picture p7: schematic balise réceptrice - puissance et communication.sch]

Parts:
C1: 1µ; E2,5-6E
D1, D2, D3, D4, D5, D6: DIODE-D-2.5; D-2.5
DC1: R-78C5.0-1.0; SIP3
IC1: 786TV; TO220V
JP1: JP1E; JP1
JP2: PINHD-1X10; 1X10
LED1, LED2, LED3, LED4: LED3MM
R1, R3, R5, R7, R9, R11: 22K; 0204/7
R2, R4, R6, R8, R10, R12: 10K; 0207/2V
R13: 220; 0204/7
SUPPLY: PINHD-1X2; 1X02
U$1: TMR-6-0523; 7SIL
U$2: TEENSY_3.0+4
U$3: 1RT
XB1: XBEE

Connections:
3.3V: U$2.3.3V, U$2.3.3V1 (3.3V)
+3V3: C1.+, IC1.3 (VO), XB1.1 (VCC)
+5V: DC1.3 (VOUT), IC1.1 (VI), U$1.VCC (VIN), U$2.VIN
+15V: JP2.1, U$1.+V (V+)
-15V: JP2.2, U$1.-V (V-)
AGND: U$2.AGND
AREF: U$2.AREF
GND: C1.-, IC1.2 (GND), JP1.1, JP2.3, JP2.10, R2.1, R4.2, R6.2, R8.2, R10.2, R12.2, R13.2, U$1.COM, U$2.GND, U$2.GND1 (GND), XB1.10 (GND)
unnamed: DC1.2 (GND), JP1.2, SUPPLY.1, U$1.GND
unnamed: D1.A, JP2.4
unnamed: U$2.7, XB1.2 (DOUT)
unnamed: U$2.8, XB1.3 (DIN/!CONFIG)
unnamed: D2.A, JP2.5
unnamed: D3.A, JP2.6
unnamed: D4.A, JP2.7
unnamed: D5.A, JP2.8
unnamed: D6.A, JP2.9
unnamed: R1.1, R2.2, U$2.15/A1
unnamed: D1.C, R1.2
unnamed: D2.C, R3.1
unnamed: R3.2, R4.1, U$2.16/A2
unnamed: D3.C, R5.1
unnamed: R5.2, R6.1, U$2.17/A3
unnamed: D4.C, R7.1
unnamed: R7.2, R8.1, U$2.18/A4
unnamed: D5.C, R9.1
unnamed: R9.2, R10.1, U$2.19/A5
unnamed: D6.C, R11.1
unnamed: R11.2, R12.1, U$2.20/A6
unnamed: DC1.1 (VIN), U$3.3 (S)
unnamed: LED1.A, U$2.6
unnamed: LED2.A, U$2.5
unnamed: LED3.A, U$2.4
unnamed: LED4.A, U$2.3
unnamed: LED1.K (C), LED2.K (C), LED3.K (C), LED4.K (C), R13.1
unnamed: SUPPLY.2, U$3.2
VBAT: U$2.VBAT
VUSB: U$2.VUSB

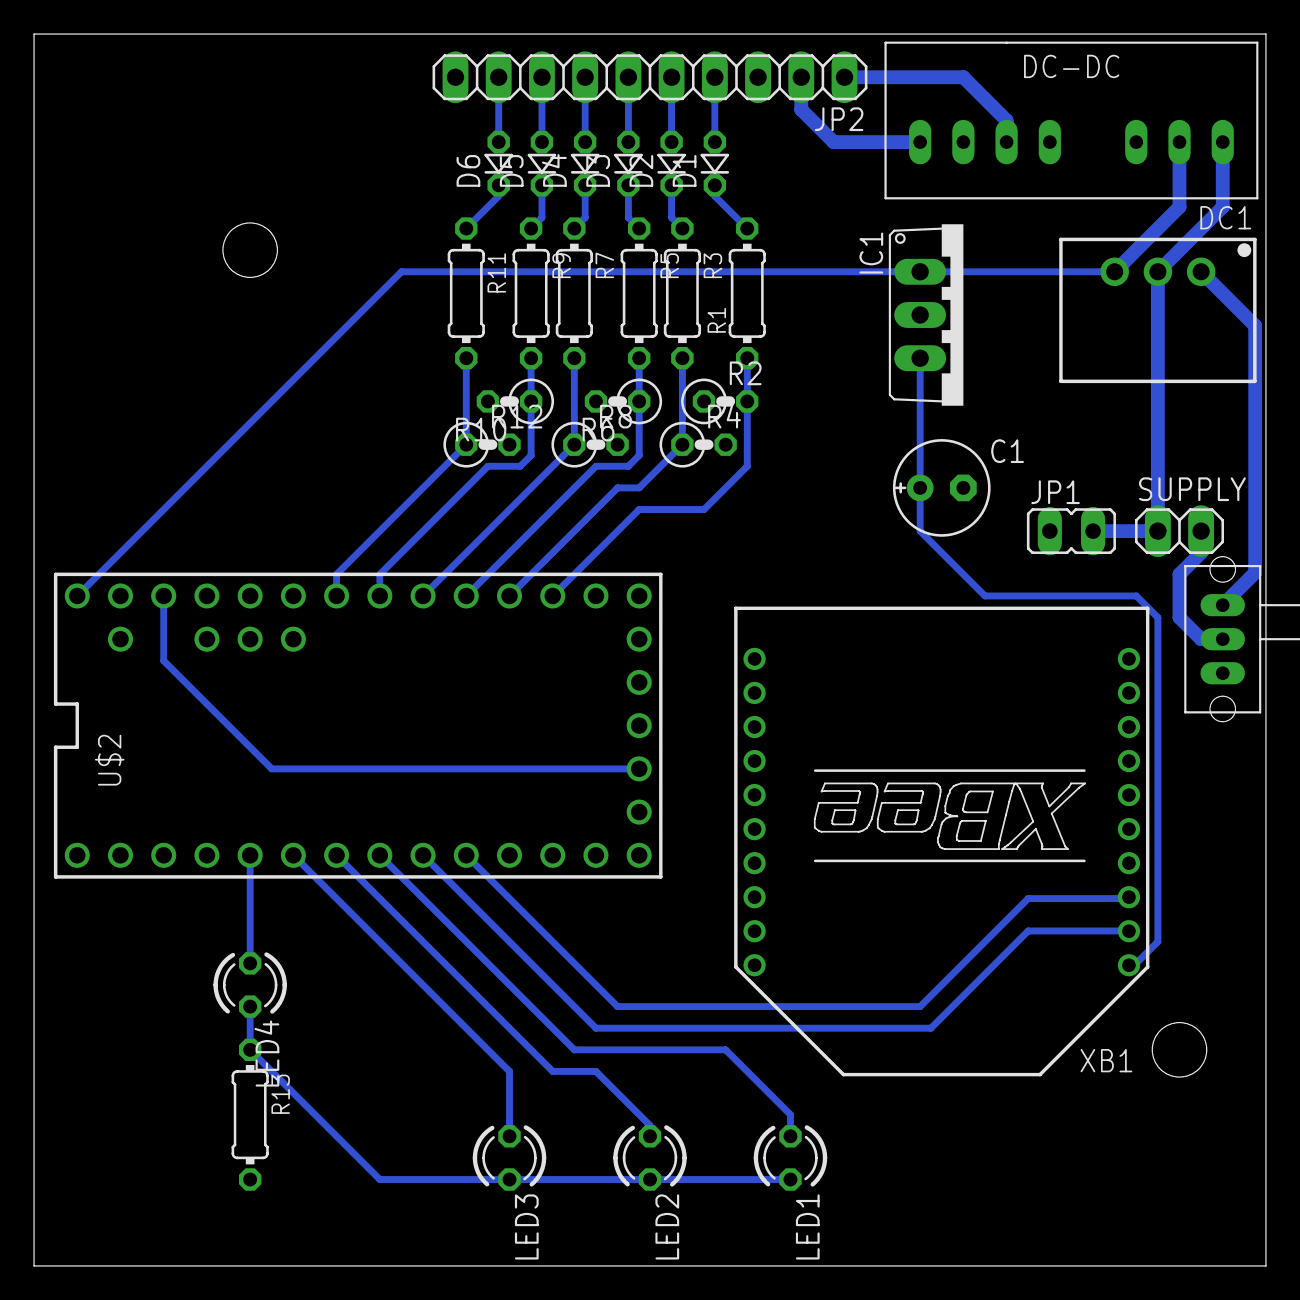
[picture p8: board balise réceptrice - puissance et communication.brd from above]

Board: 2 copper layers, 72.4 x 72.4 mm, 33 parts (0 on the bottom side), 34 nets.
