Club-INTech/Balise-Ultrasons-TechTheTroll/electronique/balise émettrice/balise émettrice analogique.brd

## EAGLE design electronique/balise émettrice/balise émettrice analogique.brd (2015-12-15)

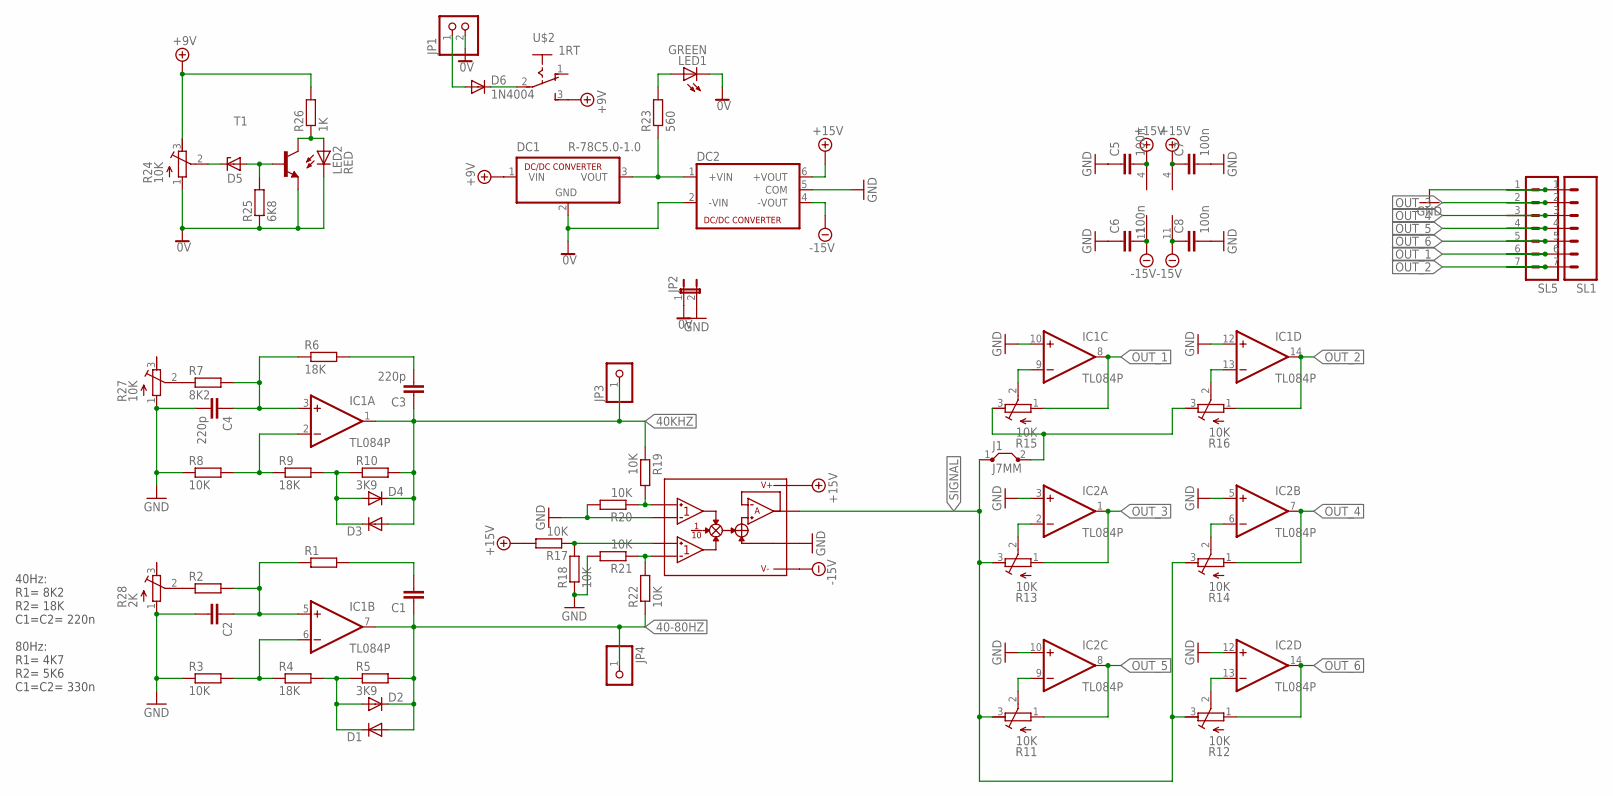
[picture p9: schematic balise émettrice analogique.sch]

Parts:
C1, C2: C-EU075-032X103; C075-032X103
C3, C4: 220p; C075-032X103; MPN EEE1EA220SP
C5, C6, C7, C8: 100n; C050-024X044
D1, D2, D3, D4: DIODE-D-2.5; D-2.5
D5: ZENER-DIODEZD-2.5; ZDIO-2.5
D6: 1N4004; DO41-10
DC1: R-78C5.0-1.0; SIP3
DC2: NMA; MPN NMA1205DC
IC1, IC2: TL084P; DIL14
J1: J7MM; 07
JP1: PINHD-1X2; 1X02
JP2: JP1E; JP1
JP3, JP4: PINHD-1X1; 1X01
LED1: GREEN; Q62902-B155
LED2: RED; Q62902-B155
R1: R-EU_0207/2V; 0207/2V
R2: R-EU_0204/7; 0204/7
R3, R8, R17, R18, R19, R20, R21, R22: 10K; 0207/2V
R4, R6, R9: 18K; 0207/2V
R5, R10: 3K9; 0207/2V
R7: 8K2; 0207/2V
R11, R12, R13, R14, R15, R16, R24, R27: 10K; RTRIM3339P
R23: 560; 0204/7
R25: 6K8; 0207/2V
R26: 1K; 0207/2V
R28: 2K; RTRIM3339P
SL1, SL5: M07; 07P
T1: 2N5400-NPN-TO92-CBE; TO92-CBE
U$1: AD633JN; DIL08
U$2: 1RT

Connections:
0V: DC1.2 (GND), DC2.2 (-VIN), JP1.2, JP2.1, LED1.K (C), LED2.K (C), R24.1 (E), R25.1, T1.E
40-80HZ: C1.1, D1.A, D2.C, IC1.7 (OUT), JP4.1, R5.2, R22.1
40KHZ: C3.1, D3.A, D4.C, IC1.1 (OUT), JP3.1, R10.2, R19.1
+9V: DC1.1 (VIN), R24.3 (A), R26.2, U$2.3 (S)
+15V: C5.2, C7.1, DC2.6 (+VOUT), IC1.4 (V+), IC2.4 (V+), R17.2, U$1.8 (+V)
-15V: C6.2, C8.1, DC2.4 (-VOUT), IC1.11 (V-), IC2.11 (V-), U$1.5 (-V)
GND: C2.2, C4.2, C5.1, C6.1, C7.2, C8.2, DC2.5 (COM), IC1.10 (+IN), IC1.12 (+IN), IC2.3 (+IN), IC2.5 (+IN), IC2.10 (+IN), IC2.12 (+IN), JP2.2, R3.1, R8.1, R18.1, R20.2, R21.2, R27.1 (E), R28.1 (E), SL1.1, SL5.1, U$1.2 (X2), U$1.6 (Z)
unnamed: IC1.6 (-IN), R3.2, R4.1
unnamed: D1.C, D2.A, R4.2, R5.1
unnamed: IC2.9 (-IN), R11.2 (S)
unnamed: C1.2, R1.2
unnamed: C2.1, IC1.5 (+IN), R1.1, R2.2
unnamed: IC1.2 (-IN), R8.2, R9.1
unnamed: D3.C, D4.A, R9.2, R10.1
unnamed: R17.1, R18.2, U$1.3 (Y1)
unnamed: C3.2, R6.2
unnamed: C4.1, IC1.3 (+IN), R6.1, R7.2
unnamed: DC1.3 (VOUT), DC2.1 (+VIN), R23.1
unnamed: IC2.13 (-IN), R12.2 (S)
unnamed: R19.2, R20.1, U$1.1 (X1)
unnamed: LED1.A, R23.2
unnamed: IC2.2 (-IN), R13.2 (S)
unnamed: R21.1, R22.2, U$1.4 (Y2)
unnamed: D5.C, R24.2 (S)
unnamed: IC2.6 (-IN), R14.2 (S)
unnamed: D5.A, R25.2, T1.B
unnamed: D6.A, JP1.1
unnamed: IC1.9 (-IN), R15.2 (S)
unnamed: LED2.A, R26.1, T1.C
unnamed: D6.C, U$2.2
unnamed: IC1.13 (-IN), R16.2 (S)
unnamed: J1.2, R15.3 (A), R16.3 (A)
unnamed: R7.1, R27.2 (S)
unnamed: R2.1, R28.2 (S)
OUT_1: IC1.8 (OUT), R15.1 (E), SL1.6, SL5.6
OUT_2: IC1.14 (OUT), R16.1 (E), SL1.7, SL5.7
OUT_3: IC2.1 (OUT), R13.1 (E), SL1.2, SL5.2
OUT_4: IC2.7 (OUT), R14.1 (E), SL1.3, SL5.3
OUT_5: IC2.8 (OUT), R11.1 (E), SL1.4, SL5.4
OUT_6: IC2.14 (OUT), R12.1 (E), SL1.5, SL5.5
SIGNAL: J1.1, R11.3 (A), R12.3 (A), R13.3 (A), R14.3 (A), U$1.7 (W)

Notes on the sheet:
40Hz: R1= 8K2 R2= 18K C1=C2= 220n 80Hz: R1= 4K7 R2= 5K6 C1=C2= 330n

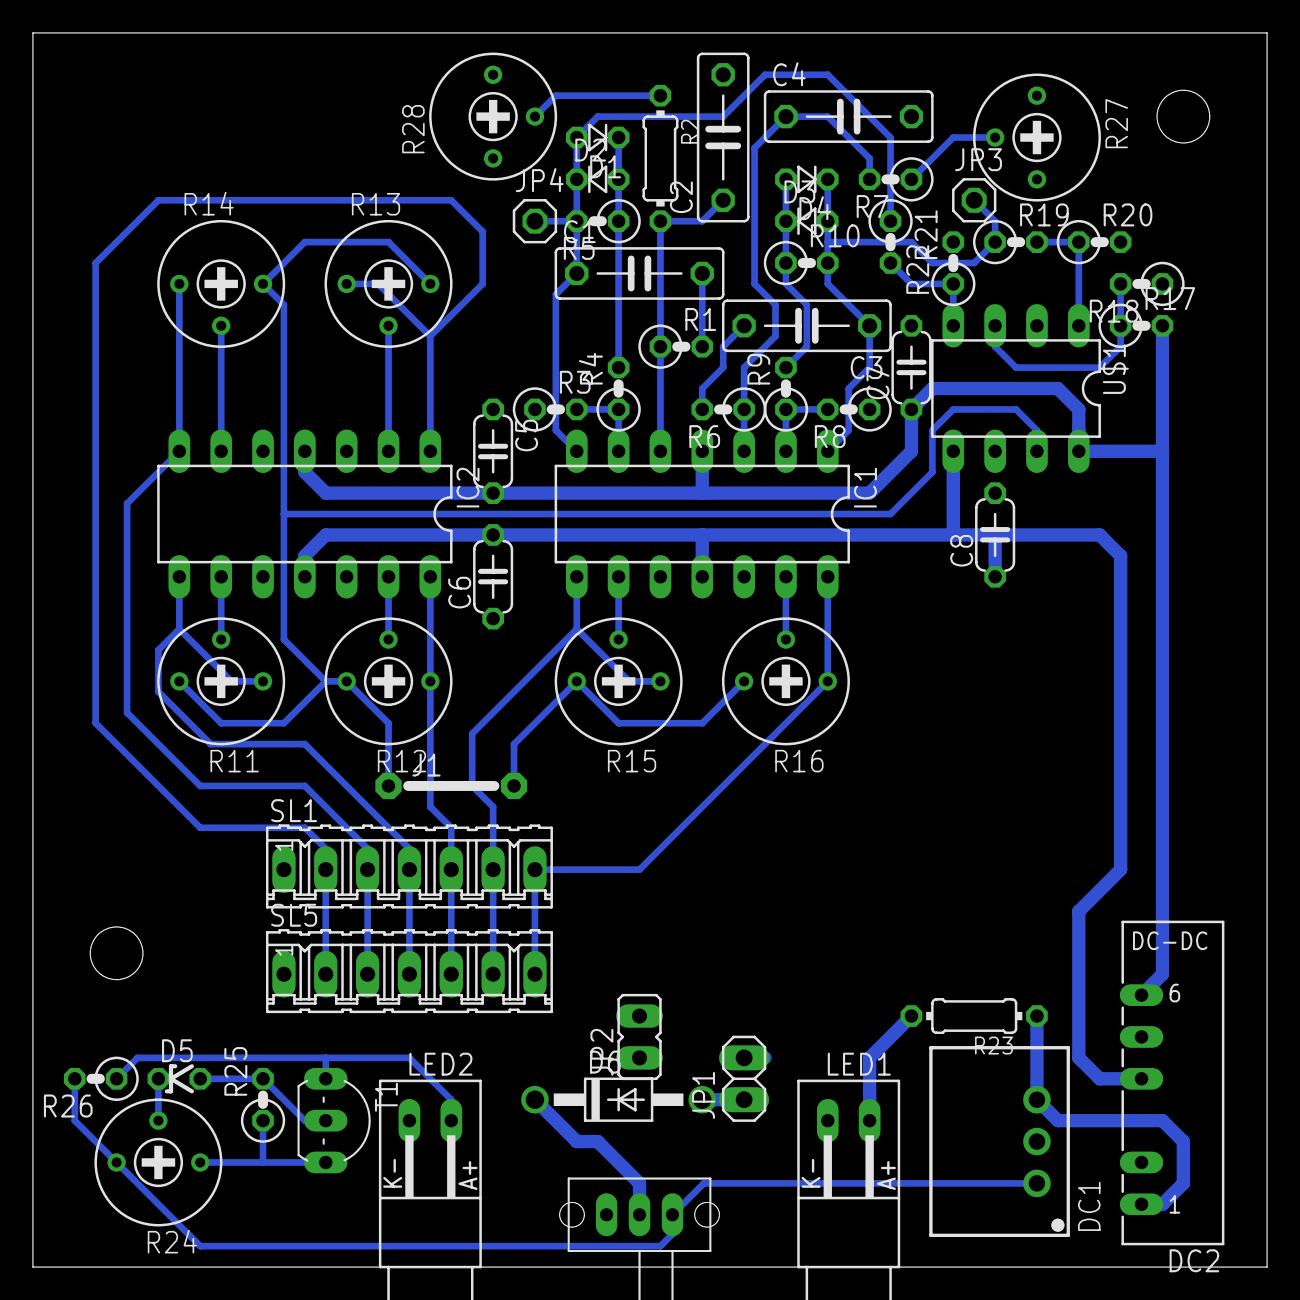
[picture p10: board balise émettrice analogique.brd from above]

Board: 2 copper layers, 74.9 x 74.9 mm, 58 parts (0 on the bottom side), 41 nets.
