Club-INTech/Balise-Ultrasons-TechTheTroll/electronique/balise réceptrice/balise réceptrice - partie filtrage.brd

## EAGLE design electronique/balise réceptrice/balise réceptrice - partie filtrage.brd (2015-12-15)

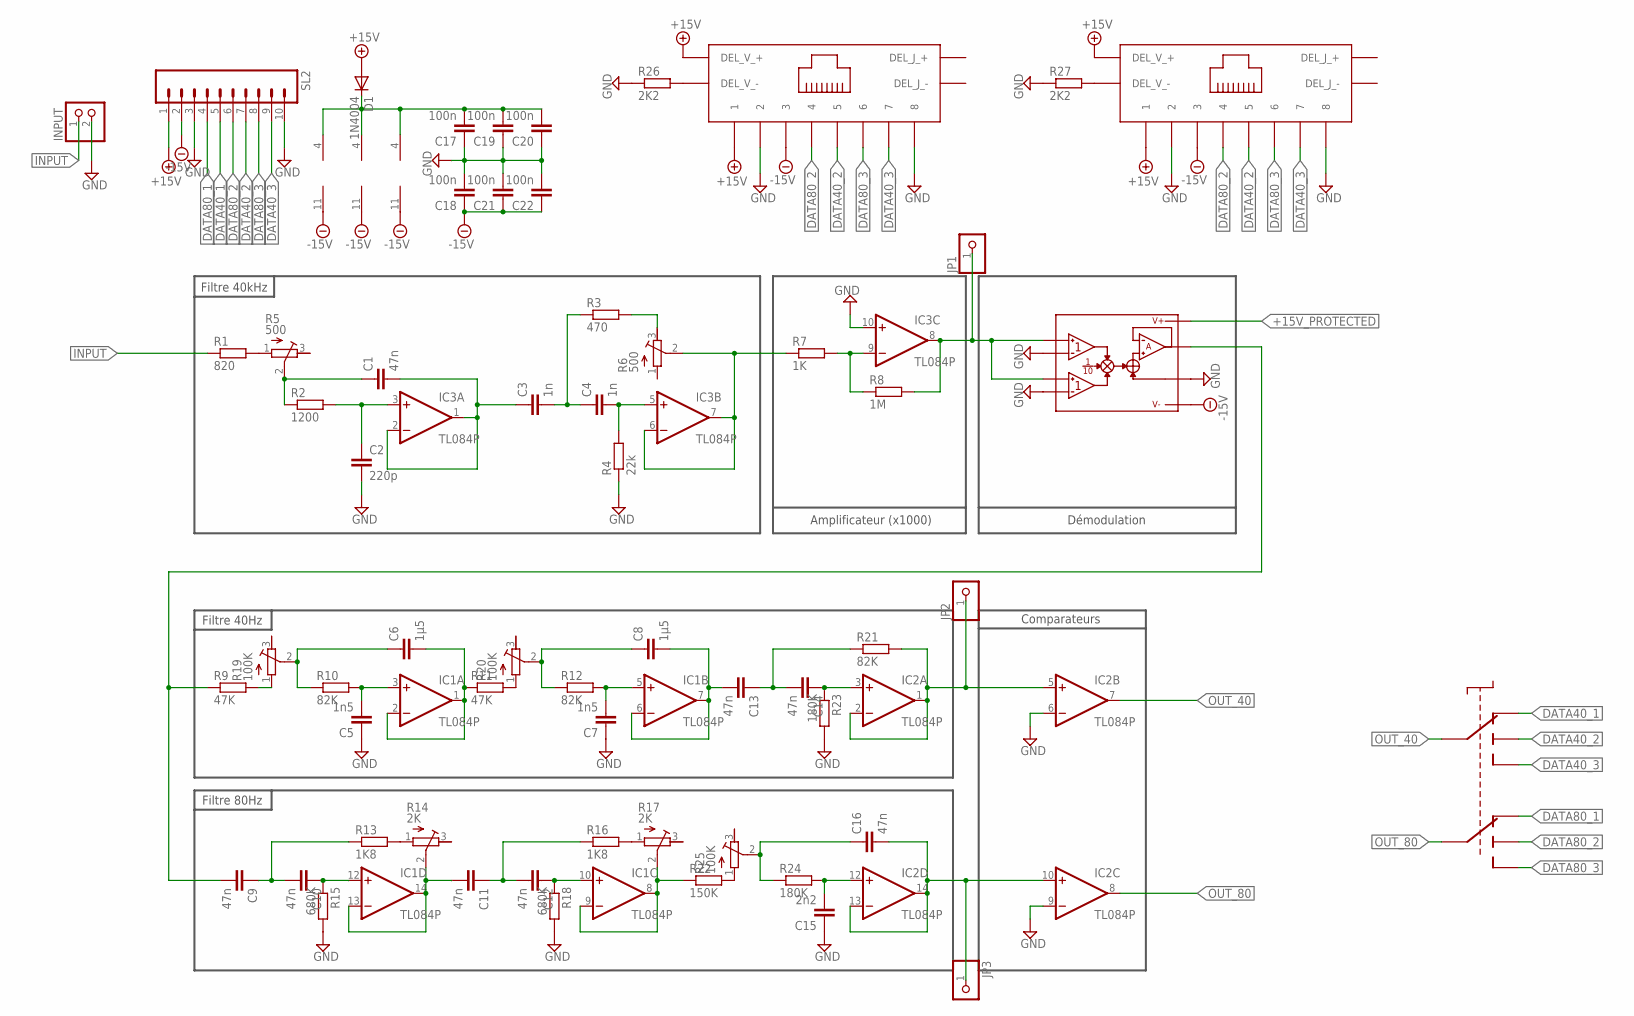
[picture p11: schematic balise réceptrice - partie filtrage.sch]

Parts:
C1, C9, C10, C11, C12, C13, C14, C16: 47n; C050-024X044
C2: 220p; C050-024X044; MPN RR1220P-104-B-T5
C3, C4: 1n; C050-024X044
C5, C7: 1n5; C050-024X044
C6, C8: 1µ5; C150-091X182
C15: 2n2; C050-024X044
C17, C18, C19, C20, C21, C22: 100n; C050-024X044
D1: 1N4004; DO41-10
IC1, IC2, IC3: TL084P; DIL14
INPUT: PINHD-1X2; 1X02
JP1, JP2, JP3: PINHD-1X1; 1X01
R1: 820; 0207/2V
R2: 1200; 0207/2V
R3: 470; 0207/2V
R4: 22k; 0207/2V
R5, R6: 500; RTRIM3339P
R7: 1K; 0204/7
R8: 1M; 0204/7
R9: 47K; 0204/7
R10: 82K; 0204/7
R11: 47K; 0207/2V
R12, R21: 82K; 0207/2V
R13, R16: 1K8; 0207/2V
R14, R17: 2K; RTRIM3339P
R15, R18: 680K; 0207/2V
R19, R20, R25: 100K; RTRIM3339P
R22: 150K; 0207/2V
R23, R24: 180K; 0207/2V
R26, R27: 2K2; 0207/2V
SL2: M10; 10P
U$1: AD633JN; DIL08
U$2, U$3: RJ45_FEMELLE
U$4: SWITCH_DP3T_SP112; SWITCH_SP112

Connections:
+15V: D1.A, SL2.1, U$2.1, U$2.DEL_V_+, U$3.1, U$3.DEL_V_+
+15V_PROTECTED: C17.2, C19.2, C20.2, D1.C, IC1.4 (V+), IC2.4 (V+), IC3.4 (V+), U$1.8 (+V)
-15V: C18.1, C21.1, C22.1, IC1.11 (V-), IC2.11 (V-), IC3.11 (V-), SL2.2, U$1.5 (-V), U$2.3, U$3.3
DATA40_1: SL2.5, U$4.1A
DATA40_2: SL2.7, U$2.5, U$3.5, U$4.1B
DATA40_3: SL2.9, U$2.7, U$3.7, U$4.1C
DATA80_1: SL2.4, U$4.2A
DATA80_2: SL2.6, U$2.4, U$3.4, U$4.2B
DATA80_3: SL2.8, U$2.6, U$3.6, U$4.2C
GND: C2.2, C5.1, C7.1, C15.1, C17.1, C18.2, C19.1, C20.1, C21.2, C22.2, IC2.6 (-IN), IC2.9 (-IN), IC3.10 (+IN), INPUT.2, R4.1, R15.2, R18.2, R23.2, R26.1, R27.1, SL2.3, SL2.10, U$1.2 (X2), U$1.4 (Y2), U$1.6 (Z), U$2.2, U$2.8, U$3.2, U$3.8
INPUT: INPUT.1, R1.1
unnamed: C2.1, IC3.3 (+IN), R2.2
unnamed: IC3.9 (-IN), R7.2, R8.1
unnamed: IC3.8 (OUT), JP1.1, R8.2, U$1.1 (X1), U$1.3 (Y1)
unnamed: R1.2, R5.1 (E)
unnamed: C1.1, R2.1, R5.2 (S)
unnamed: C1.2, C3.1, IC3.1 (OUT), IC3.2 (-IN)
unnamed: C3.2, C4.1, R3.1
unnamed: C4.2, IC3.5 (+IN), R4.2
unnamed: IC3.6 (-IN), IC3.7 (OUT), R6.2 (S), R7.1
unnamed: R3.2, R6.3 (A)
unnamed: R26.2, U$2.DEL_V_-
unnamed: C6.1, R10.1, R19.2 (S)
unnamed: C5.2, IC1.3 (+IN), R10.2
unnamed: C6.2, IC1.1 (OUT), IC1.2 (-IN), R11.1
unnamed: R13.2, R14.1 (E)
unnamed: C8.1, R12.1, R20.2 (S)
unnamed: C7.2, IC1.5 (+IN), R12.2
unnamed: C8.2, C13.2, IC1.6 (-IN), IC1.7 (OUT)
unnamed: C9.1, C10.2, R13.1
unnamed: C11.2, IC1.13 (-IN), IC1.14 (OUT), R14.2 (S)
unnamed: C10.1, IC1.12 (+IN), R15.1
unnamed: R16.2, R17.1 (E)
unnamed: C11.1, C12.2, R16.1
unnamed: IC1.8 (OUT), IC1.9 (-IN), R17.2 (S), R22.1
unnamed: C12.1, IC1.10 (+IN), R18.1
unnamed: C9.2, R9.1, U$1.7 (W)
unnamed: R9.2, R19.1 (E)
unnamed: R11.2, R20.1 (E)
unnamed: C16.1, R24.1, R25.2 (S)
unnamed: C15.2, IC2.12 (+IN), R24.2
unnamed: C13.1, C14.2, R21.1
unnamed: IC2.1 (OUT), IC2.2 (-IN), IC2.5 (+IN), JP2.1, R21.2
unnamed: C14.1, IC2.3 (+IN), R23.1
unnamed: C16.2, IC2.10 (+IN), IC2.13 (-IN), IC2.14 (OUT), JP3.1
unnamed: R22.2, R25.1 (E)
unnamed: R27.2, U$3.DEL_V_-
OUT_40: IC2.7 (OUT), U$4.COM_1 (COM1)
OUT_80: IC2.8 (OUT), U$4.COM_2 (COM2)

Notes on the sheet:
Filtre 40Hz
Filtre 80Hz
Comparateurs
Filtre 40kHz
Amplificateur (x1000)
Démodulation

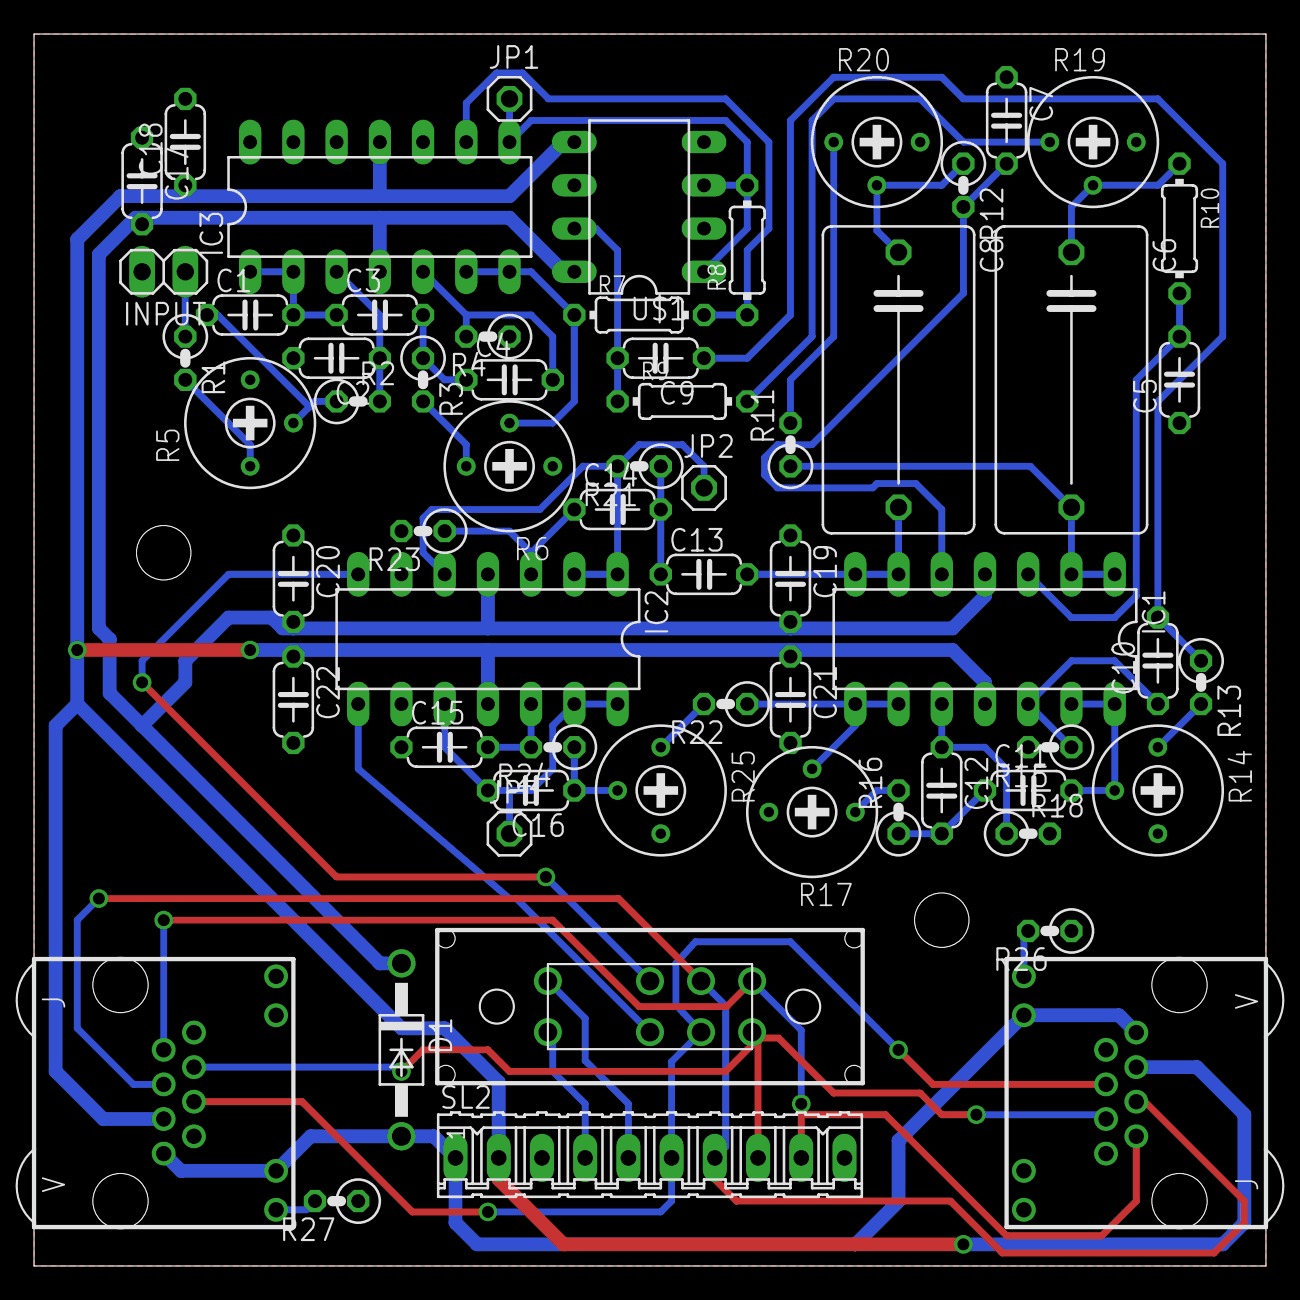
[picture p12: board balise réceptrice - partie filtrage.brd from above]

Board: 2 copper layers, 72.4 x 72.4 mm, 62 parts (0 on the bottom side), 49 nets.
