Club-INTech/Balise-Ultrasons-TechTheTroll/electronique/filtre/filtre 40kHz.brd

## EAGLE design electronique/filtre/filtre 40kHz.brd (2015-07-01)

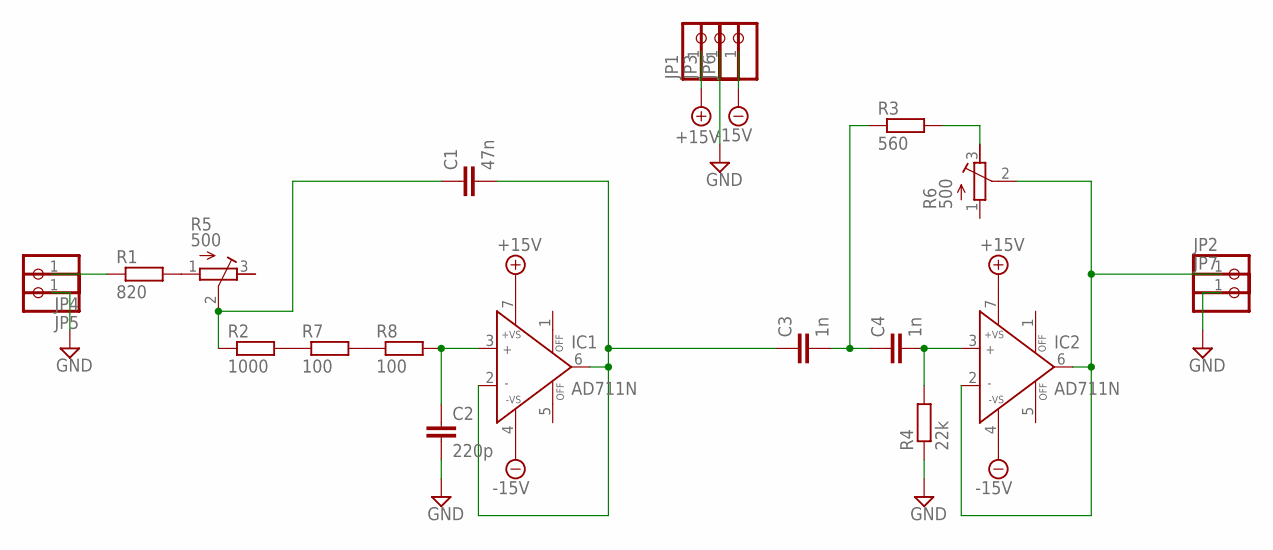
[picture p13: schematic filtre 40kHz.sch]

Parts:
C1: 47n; C050-024X044
C2: 220p; C050-024X044
C3: 1n; C075-032X103
C4: 1n; C050-024X044
IC1, IC2: AD711N; DIL08
JP1, JP2, JP3, JP4, JP5, JP6, JP7: PINHD-1X1; 1X01
R1: 820; 0204/7
R2: 1000; 0204/7
R3: 560; 0204/7
R4: 22k; 0204/7
R5, R6: 500; RTRIM3339P
R7, R8: 100; 0207/2V

Connections:
+15V: IC1.7 (+VS), IC2.7 (+VS), JP1.1
-15V: IC1.4 (-VS), IC2.4 (-VS), JP6.1
GND: C2.2, JP3.1, JP5.1, JP7.1, R4.1
unnamed: C2.1, IC1.3 (IN+), R8.2
unnamed: R2.2, R7.1
unnamed: R7.2, R8.1
unnamed: R1.2, R5.1 (E)
unnamed: C1.1, R2.1, R5.2 (S)
unnamed: C1.2, C3.1, IC1.2 (IN-), IC1.6 (OUT)
unnamed: C3.2, C4.1, R3.1
unnamed: C4.2, IC2.3 (IN+), R4.2
unnamed: IC2.2 (IN-), IC2.6 (OUT), JP2.1, R6.2 (S)
unnamed: R3.2, R6.3 (A)
unnamed: JP4.1, R1.1

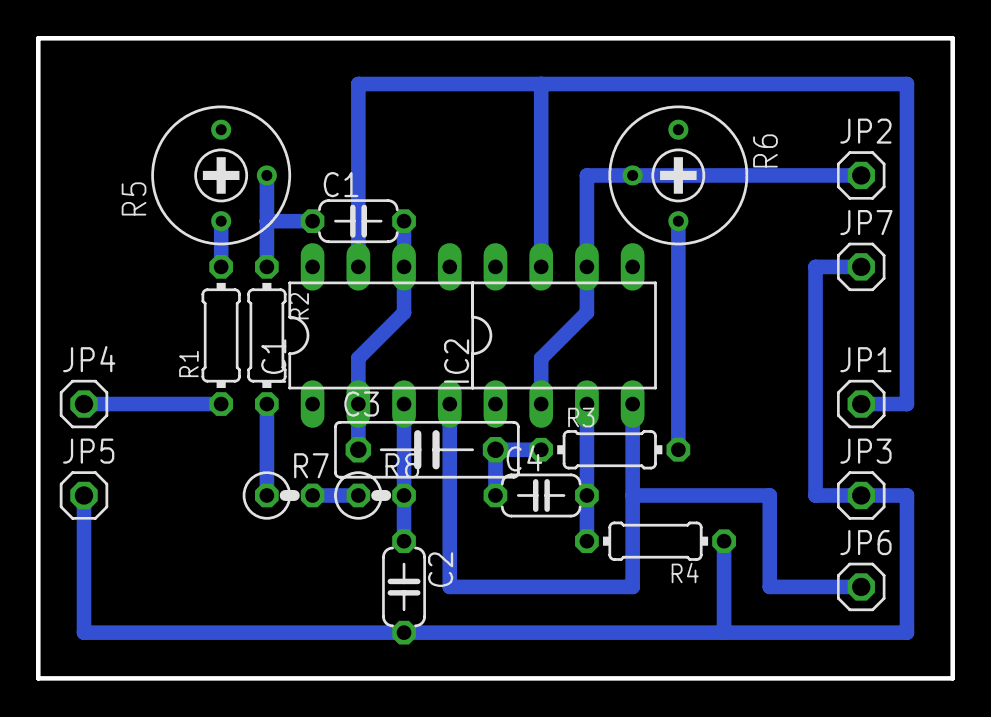
[picture p14: board filtre 40kHz.brd from above]

Board: 2 copper layers, 50.8 x 35.6 mm, 21 parts (0 on the bottom side), 14 nets.
