Club-INTech/Balise-Ultrasons-TechTheTroll/electronique/balise émettrice/version numérique/balise émettrice.brd

## EAGLE design electronique/balise émettrice/version numérique/balise émettrice.brd (2015-06-25)

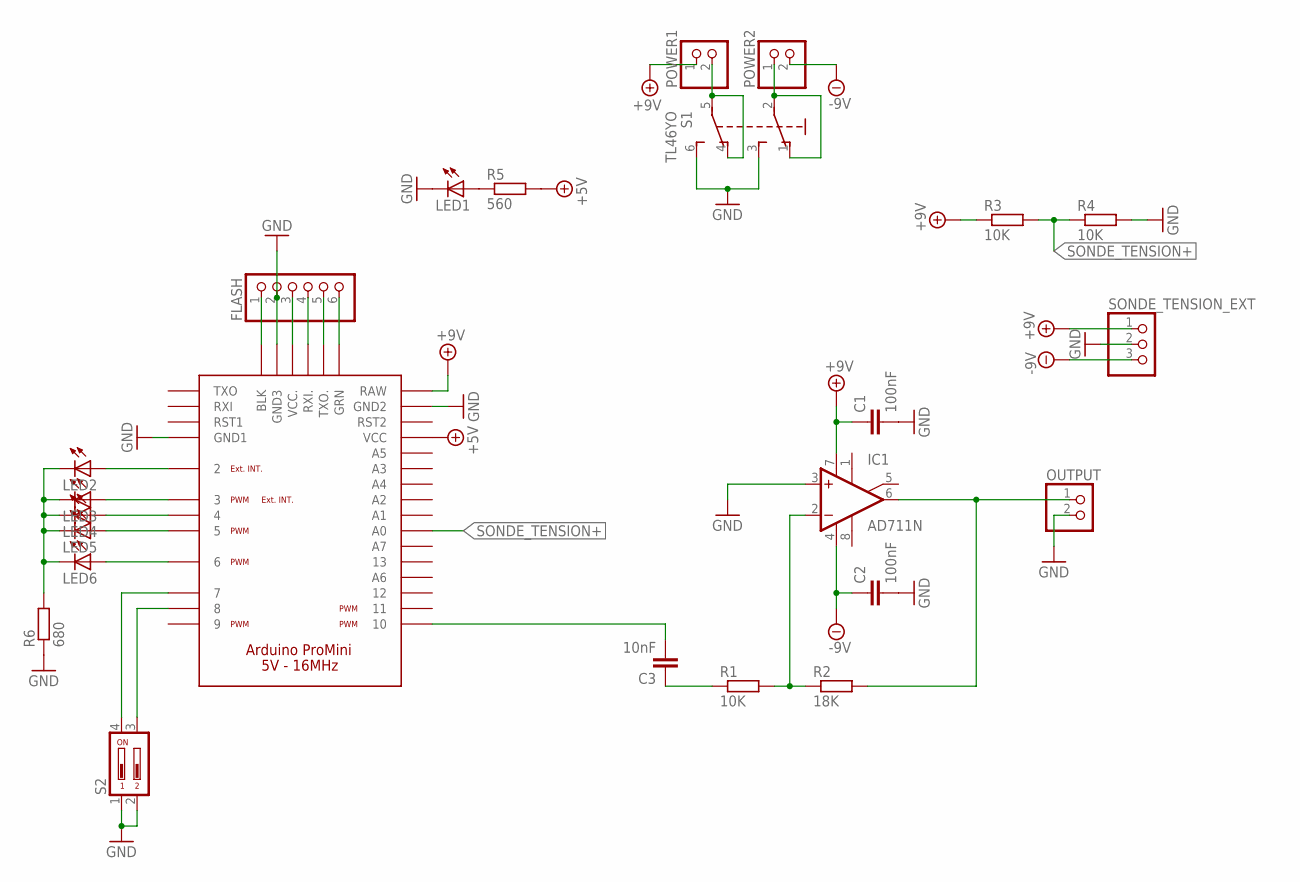
[picture p15: schematic balise émettrice.sch]

Parts:
C1, C2: 100nF; C050-024X044
C3: 10nF; C050-024X044
FLASH: PINHD-1X6/90; 1X06/90
IC1: AD711N; DIL08
LED1: LEDB155; Q62902-B155
LED2, LED3, LED4, LED5, LED6: LED3MM
OUTPUT: PINHD-1X2; 1X02
POWER1, POWER2: PINHD-1X2; 1X02
R1, R3, R4: 10K; 0204/7
R2: 18K; 0204/7
R5: 560; 0207/12
R6: 680; 0204/7
S1: TL46YO; TL4XYO
S2: DA02; DA-02
SONDE_TENSION_EXT: PINHD-1X3; 1X03
U$1: ARDUINO_PRO_MINI

Connections:
+5V: R5.2, U$1.VCC1 (VCC)
+9V: C1.1, IC1.7 (V+), POWER1.1, R3.1, SONDE_TENSION_EXT.1, U$1.RAW
-9V: C2.1, IC1.4 (V-), POWER2.2, SONDE_TENSION_EXT.3
GND: C1.2, C2.2, FLASH.2, IC1.3 (+IN), LED1.K (C), OUTPUT.2, R4.2, R6.1, S1.3 (S), S1.6 (S1), S2.1, S2.2, SONDE_TENSION_EXT.2, U$1.GND1, U$1.GND2, U$1.GND3
unnamed: FLASH.1, U$1.BLK
unnamed: IC1.6 (OUT), OUTPUT.1, R2.2
unnamed: IC1.2 (-IN), R1.2, R2.1
unnamed: LED1.A, R5.1
unnamed: FLASH.3, U$1.VCC2 (VCC.)
unnamed: FLASH.4, U$1.RXI2 (RXI.)
unnamed: FLASH.5, U$1.TXO2 (TXO.)
unnamed: FLASH.6, U$1.GRN
unnamed: C3.1, R1.1
unnamed: LED2.A, U$1.2
unnamed: LED3.A, U$1.3
unnamed: LED4.A, U$1.4
unnamed: LED5.A, U$1.5
unnamed: LED6.A, U$1.6
unnamed: LED2.K (C), LED3.K (C), LED4.K (C), LED5.K (C), LED6.K (C), R6.2
unnamed: POWER1.2, S1.4 (O1), S1.5 (P1)
unnamed: POWER2.1, S1.1 (O), S1.2
unnamed: S2.4, U$1.7
unnamed: S2.3, U$1.8
unnamed: C3.2, U$1.10
SONDE_TENSION+: R3.2, R4.1, U$1.A0

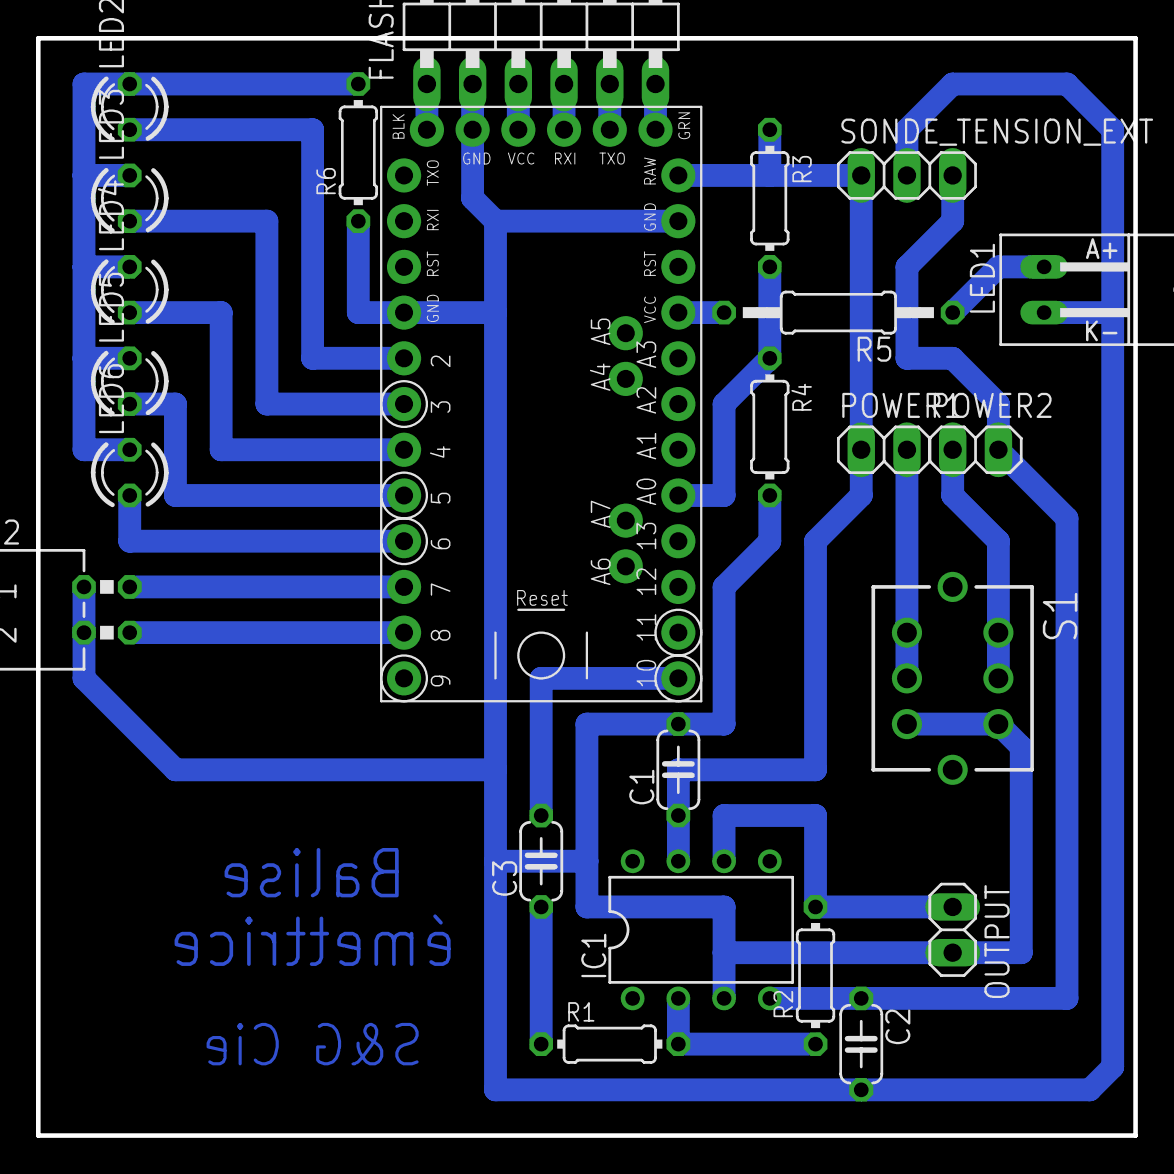
[picture p16: board balise émettrice.brd from above]

Board: 2 copper layers, 61.0 x 61.0 mm, 24 parts (0 on the bottom side), 25 nets.
