Club-INTech/Balise-Ultrasons-TechTheTroll/electronique/oscilateur/oscilateur.brd

## EAGLE design electronique/oscilateur/oscilateur.brd (2015-06-25)

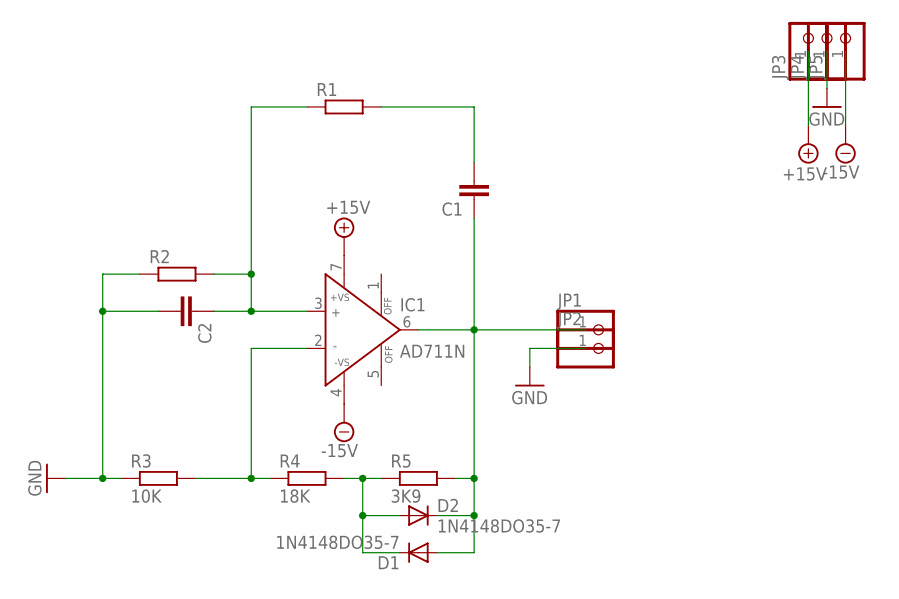
[picture p17: schematic oscilateur.sch]

Parts:
C1, C2: C-EU075-032X103; C075-032X103
D1, D2: 1N4148DO35-7; DO35-7
IC1: AD711N; DIL08
JP1, JP2, JP3, JP4, JP5: PINHD-1X1; 1X01
R1, R2: R-EU_0204/7; 0204/7
R3: 10K; 0204/7
R4: 18K; 0204/7
R5: 3K9; 0204/7

Connections:
+15V: IC1.7 (+VS), JP3.1
-15V: IC1.4 (-VS), JP5.1
GND: C2.2, JP2.1, JP4.1, R2.1, R3.1
unnamed: IC1.2 (IN-), R3.2, R4.1
unnamed: D1.C, D2.A, R4.2, R5.1
unnamed: C1.1, D1.A, D2.C, IC1.6 (OUT), JP1.1, R5.2
unnamed: C1.2, R1.2
unnamed: C2.1, IC1.3 (IN+), R1.1, R2.2

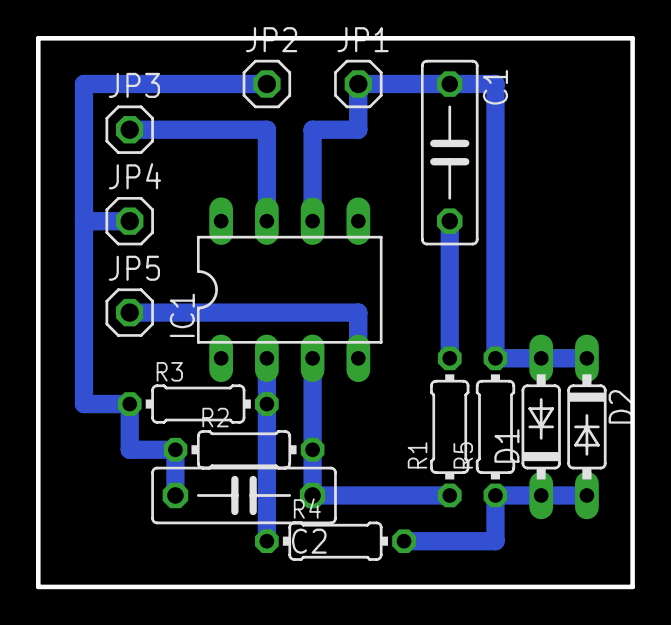
[picture p18: board oscilateur.brd from above]

Board: 2 copper layers, 33.0 x 30.5 mm, 15 parts (0 on the bottom side), 8 nets.
