Club-INTech/Balise-Ultrasons-TechTheTroll/software/BaliseT3/BaliseT3/enum.h

#ifndef _ENUM_h
#define _ENUM_h

//#if defined(ARDUINO) && ARDUINO >= 100
	//#include "arduino.h"
//#else
	#include "WProgram.h"
//#endif

// D�finition des permissions d'�criture
enum Permission
{
	CAN_BE_FIRST,
	CANT_BE_FIRST,
	MUST_BE_LAST
};

#endif
