Club-INTech/Balise-Ultrasons-TechTheTroll/software/BaliseT3/BaliseT3/Positionning.cpp

#include "Positionning.h"

Positionning::Positionning()
{
}

void Positionning::updatePosition(uint32_t t1, uint32_t t2, uint32_t t3)
{
}

float Positionning::getX()
{
	return 0.0f;
}

float Positionning::getY()
{
	return 0.0f;
}
