Club-INTech/Balise-Ultrasons-TechTheTroll/(commit log)

2015-06-25 premier commit
    [balise réceptrice.sch, balise émettrice analogique.sch, balise émettrice.brd, balise émettrice.sch, multiplieur.sch, oscilateur.brd, oscilateur.sch]
2015-06-25 nettoyage des fichiers qui se revelent penibles a versionner...
2015-06-25 Revert "nettoyage des fichiers qui se revelent penibles a versionner..."
    This reverts commit 4f999430c8d0b5a707e8b82945da2f093fba8c61.
2015-06-25 Revert "Revert "nettoyage des fichiers qui se revelent penibles a versionner...""
    This reverts commit 346a37e5f3388ba9037312f81a1cfd123524a31b.
2015-06-25 Revert "Revert "Revert "nettoyage des fichiers qui se revelent penibles a versionner..."""
    This reverts commit f60757fa0cf28b790f92727b243827b64f0c8f21.
2015-06-25 bon, ce coup ci je sais ce que fait git revert. Et c'est bien pourri. Il y a des fichiers un peu lourds que j'ai push et qui sont desormai dans le gitignore, mais il m'est impossible de les supprimer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
2015-07-01 circuit balise emission + filtre 80Hz
    [balise émettrice analogique.brd, filtre 40kHz.brd, filtre 40kHz.sch]
2015-07-04 maj elec balise emettrice
    [balise émettrice analogique.brd, balise émettrice analogique.sch]
2015-07-06 ajout .stl + maj modeles 3D + maj elec + maj filtrage
    [balise émettrice analogique.brd]
2015-07-07 correctif equations des filtres + ajout debut circuit de reception
    [balise réceptrice - partie filtrage.brd, balise réceptrice - partie filtrage.sch, balise réceptrice.sch, balise émettrice analogique.brd, balise émettrice analogique.sch]
2015-07-11 maj filtrage + ajout routage balise receptrice, partie filtrage
    [Valeurs des composants.xlsx, balise réceptrice - partie filtrage.brd, balise réceptrice - partie filtrage.sch, balise émettrice analogique.brd, balise émettrice analogique.sch]
2015-07-15 derniere carte elec : la puissance et la communication sans fil + maj modele 3D balise receptrice
    [balise réceptrice - partie filtrage.brd, balise réceptrice - partie filtrage.sch, balise réceptrice - puissance et communication.brd, balise réceptrice - puissance et communication.sch]
2015-07-16 release modele 3D + elec :D
    [balise réceptrice - puissance et communication.brd, balise réceptrice - puissance et communication.sch]
2015-07-16 maj balise emettrice : ajout de la DEL de debug + interrupteur dans le modele 3D
    [balise émettrice analogique.brd, balise émettrice analogique.sch]
2015-07-16 ajout des .stl
2015-08-15 maj mineure elec + ajout doc de l'elec
    [balise émettrice analogique.brd, balise émettrice analogique.sch]
2015-09-23 ajout des fichiers gerber et excellon
    [balise réceptrice - partie filtrage.brd, balise réceptrice - puissance et communication.brd, balise réceptrice - puissance et communication.sch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]
2015-10-12 Papiers présentants le filtrage de Kalman adapté au problème
2015-10-16 Je suis le premier ! fonctiosn pour retrouver la position du robot à partir des mesures, un filtrage de Kalman classique et le Unscented
2015-10-27 ajout de l'encodage, important en Python 2.x
2015-10-27 ajout de l'encodage, algorithme de Kalman Unscented. Fichier non fini
2015-11-11 Doc pour s'instruire sur le fitrage de Kalman
2015-12-15 ajout des factures, devis, et bilans financiers
    [liste des courses.xlsx]
2015-12-15 ajout de la TVA ^^
    [liste des courses.xlsx]
2015-12-15 maj liste des composants
    [balise réceptrice - partie filtrage.brd, balise réceptrice - partie filtrage.sch, balise émettrice analogique.brd, balise émettrice analogique.sch, liste des courses.xlsx]
2016-02-28 Ajout des mesures faites par Julian pour tester le filtrage
2016-02-28 Amélioration de quelques parties du code. Problème de dimensionnement de vecteurs
2016-03-05 Ajout doc + mise a jour des modeles 3D
    [balise réceptrice - puissance et communication.brd, balise réceptrice - puissance et communication.sch, liste des courses.xlsx]
2016-03-06 Le filtre est désormais cohérent au niveau des dimensions. Il reste encore des problèmes quand à la cohérence des résultats. Par exemple, la racine carré d'une matrice peut devenir complexe au bout d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
2016-03-06 Un * corrigé en un + et on obtient de meilleurs résultats ! Enfin, tout reste dans le même ordre de grandeur. On peut dire que le programme est débogué, mais pas encore opérationnel : beaucoup de par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
2016-03-30 Ajout d'un script qui génère comme on veut des mesures de position d'un robot sur la table de jeu.
2016-03-30 Renommage de fichiers. Ajout d'un script utilisant le générateur de chemin. Test. A ajouter : l'analyse des erreurs.
2016-03-31 Documentation ajoutée. Je passe le code à Monf aussi, il a besoin de mesures et ça peut aider.
2016-04-05 ajout de trajectoires bruités pour des tests
2016-04-13 Séparation du code sur le filtrage et sur les structures de données
2016-04-13 Utilisation de structure.py
2016-04-13 utilisation de structure et ajout d'un terme dans les sommes. L'algo n'est pas encore totalement prêt.
2016-04-25 de meilleures valeurs, mais c'est toujours un peu "nul"
2016-04-27 Filtre de Kalman d'Ivan
2016-04-30 Test de la méthode d'Ivan
2016-04-30 On essaye de trouver les meilleures valeurs pour les matrices de covariance.
2016-05-02 Des avancées ? Pas sûr. Oui, j'aime pas écrire des trucs utiles.
2016-05-10 ajout code Teensy
2016-05-13 maj soft teensy
2016-05-14 Ajout d'un module qui permet de lire les mesures effectuées par Sylvain et reçu sous la forme d'un fichier texte.
2016-05-14 Ajout des données brutes des balises et des données légèrement retouchées
2016-05-15 ajout des données résultats des tests pour Clément, et correction du code bas niveau
    [BaliseT3.ino, Communication.cpp]
2016-05-21 Début du pseudo-code du filtrage de Kalman
2016-05-22 Pseudo-code totalement écrit. Ajout d'une documentation. Modélisation plus précise. Ajout d'une partie sur l'explication sur les notations.
2016-07-21 ajout de mesures
2016-07-22 ajout script python de traitement sommaire des benchmark
2016-07-22 commit pré-merge, gardons la foi.
    [Data4.xlsx]
2016-07-23 Affichage des données
2016-07-23 Lecture de fichier, debug multithreading
2016-07-25 Conversion entre deux formats de fichiers
2016-07-25 Affichage des demi-hyperboles
2016-07-25 Suppression de la 2e solution
2016-07-25 Ligne de commande + jar
2016-07-25 Conversion des P1, …, P9 en format vanille-chocolat
2016-07-26 Triangulation choisit la bonne solution
2016-07-26 Meilleure gestion quand il y a plusieurs trajectoires
2016-07-26 Petit test de sensibilité au bruit
2016-07-26 Séparation du calcul de filtrage et de l'affichage afin de pouvoir s'interfacer avec les filtres python
2016-07-26 Positions brutes de P1 pour tester le Kalman
2016-07-26 test du filtre de Kalman avec des mesures converties analytiquement
2016-07-26 Des entiers pour les positions !!!
2016-07-27 ajout de documentation
2016-07-27 print en ligne
2016-07-28 La triangulation vérifie la cohérence des données
2016-07-28 ajout des premiers relevés de test
2016-08-04 Ajout script python pour créer la base de données de mesures permettant de réaliser la fonction inverse.
